pailpoe/MiniThread/documentation/Doc Utilisation_ MiniThread_r4.pdf

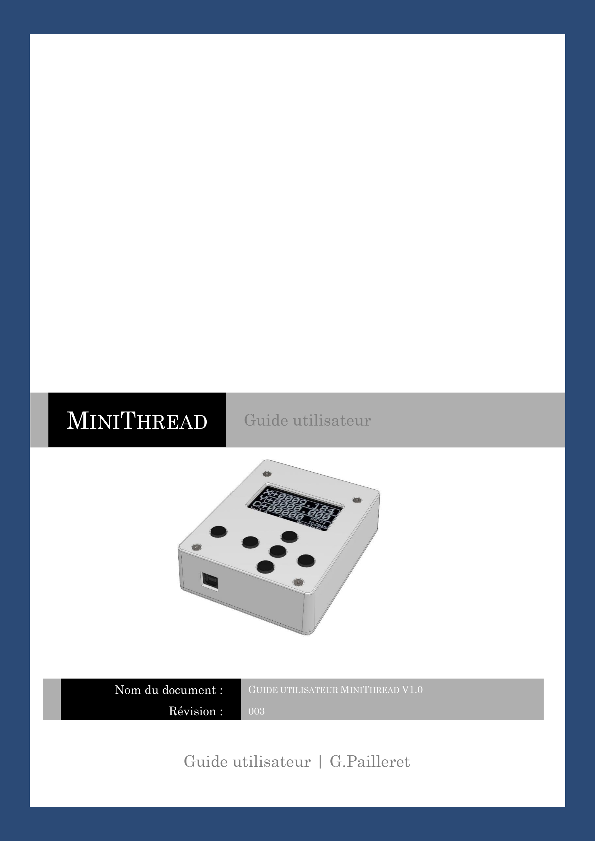
[picture p1: page 1]

## Guide utilisateur | G.Pailleret

MINITHREAD | Guide utilisateur
Nom du document : | GUIDE UTILISATEUR MINITHREAD V1.0
Révision : | 003

MiniThread | Guide utilisateur | 29 novembre

## Table des révisions

Révision | Détails | Auteur | Date
000 | Création du document | G.Pailleret | 21/11/2020
001 | Modification mineure Ajout calcul formule offset variable dans Annexe 3 | G.Pailleret | 21/11/2020
002 | Rajouts de détails dans différentes sections. Mise à
jour de la doc en fonction du logiciel 1.1.0.

Documentation écrite pour un choix de langue « FR »

G.Pailleret | 29/11/2020
003 | Ajout des profils Sphère et cône en intérieur /
extérieur et gauche /droite de la version logiciel 1.2.0.
G.Pailleret | 06/12/2020

## Table des matières

### 1. PRESENTATION

## 1.1 Avertissement

ATTENTION : Veuillez lire et comprendre l’intégralité du présent manuel avant de tenter d’installer ou de faire fonctionner le boitier MiniThread pour éviter tous risques d’accident grave.

ATTENTION : Le boitier MiniThread est un développement Open source (hardware, software, mécanique). Je ne suis pas responsable des dommages que sa mauvaise utilisation ou une défaillance du boitier pourraient occasionner. Soyez conscient des risques que vous prenez.

Toutes reproductions à des fins commerciales est interdites ! Me contacter si besoin.

## 1.2 Le projet

Le boitier MiniThread est un développement « DIY » open-source développé par Guillaume Pailleret (pseudo Pailpoe sur le forum français www.usinages.com »). Il représente des centaines d’heure de travail étalé sur 2 ans pour concevoir la carte, le logiciel, la mécanique et la documentation associée !

Le logiciel est disponible sur mon dépôt github : https ://github.com/pailpoe/MiniThread

Adresse email de contact : minithread@laposte.net

## 1.3 Remerciement

Je tiens à remercier les personnes sans qui ce projet n’aurait jamais vu le jour :

- Roger Clarke pour le Core Arduino pour STM32F103 qui m’a énormément simplifié le travail ( https ://github.com/rogerclarkmelbourne/Arduino_STM32 )
- Alexander ‘Spirik’ Spiridonov pour sa librairie de gestion de menus GEM qui est le cœur du système et qui m’a donné envie de relancer le projet en pause depuis 1 an
(https ://github.com/Spirik/GEM) .
- Mike McCauley pour sa librairie de gestion des moteurs pas à pas AccelStepper qui m’a servi pour la mise en place de l’accélération
(https ://www.airspayce.com/mikem/arduino/AccelStepper/).
- Les membres du forum Usinages.com qui m’ont motivé à avancer.

## 1.4 Document

Ce document à plusieurs objectifs :

- Expliquer comment utiliser le boitier MiniThread.
- Expliquer comment le régler.
- Expliquer comment choisir les composants externes comme les capteurs de position, les moteurs et les drivers.
- …

## 1.5 Le boitier MiniThread : les fonctionnalités

Le boitier MiniThread est destiné à offrir des fonctionnalités supplémentaires à un tour à métaux. Les fonctions dépendent de l’équipement du tour :

Fonctionnalités du boitier MiniThread en fonction de l’équipement

Axe longitudinal
Capteur sur le X

# Capteur sur le Y Axe transversal

Axe
Capteur sur le C

de broche

Axe longitudinal
Moteur sur le X

Axe
Moteur sur le Y

transversal

Général
Interface multi langue : Français et Anglais

Sauvegarde des réglages à la remise sous tension

DRO fonctions (affichage de position)

Affichage de la position de l’axe X au 1/1000 de mm | X
Remise à zéro de l’axe X | X
Affichage de la position de l’axe Y au 1/1000 de mm | | X
Remise à zéro de l’axe Y | | X
Mode diamètre pour l’axe Y | | X
Entrer d’une valeur pour un axe (ex : 12.5) | X | X
Correcteur d’outils (10 outils) sur X et Y | X | X
Mode Absolu / relatif pour les axes X et Y | X | X
Affichage de la vitesse de la broche en tour/min | | | X
Affichage de la position de la broche sur un tour en degré | | | X

Fonctions de chariotage sur longitudinal

Chariotage Automatique ou manuel sur butée électronique | X
Ajustement rapide des butées électronique en Manuel | X
Réglage des butées, déplacement des butées, … | X
Passage en mode rapide « bouton » | X

Fonctions de filetage

Filetage semi-automatique entre butées électronique ( int, ext, gauche et droite). | | X | X
Décalage dans le pas pour la reprise de filets endommagés | | X | X
Descente oblique avec choix de l’angle en degré | X | X | X

Fonctions de profil (sphère, cône)

Profil en mode semi-automatique (l’opérateur gère le transversal en manuel) | X | X
Profil à droite | X | X
Profil à gauche | X | X
Profil intérieur | X | X
Profil extérieur | X | X

Sphère (choix du rayon, de la position) | X | X
Congé (choix de l’angle, de la longueur) | X | X

Le boitier a été développé à la base pour être monté sur un tour d’outilleur type Schaublin 102 mais il peut être monté sur d’autres tours de plus ou moins grande taille en adaptant certains composants externes au boitier.

Exemple de réalisations possible avec le boitier :

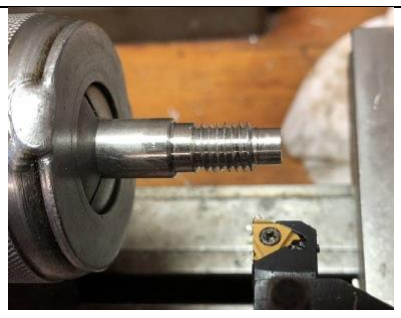
[picture p2: figure]

Filetage extérieur

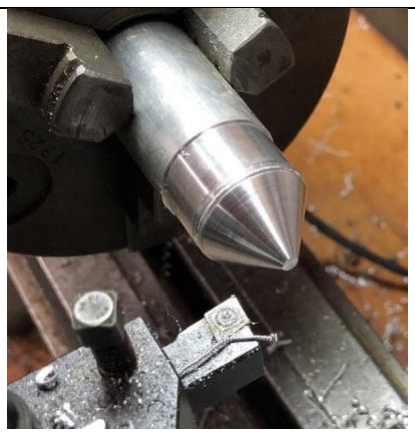
[picture p3: figure]

Cônes

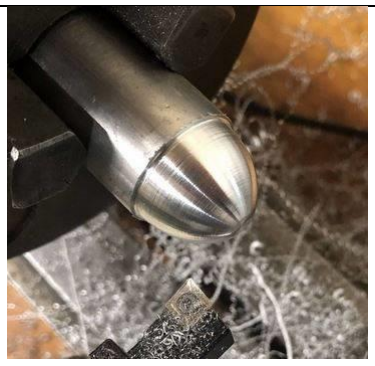
[picture p4: figure]

Sphères

## 1.6 Les axes du boitier

Les axes sont assignés de cette façon sur le boitier (qui diffère du standard !!). Cette notation est historique au projet et sera peut-être changé si j’ai le temps.

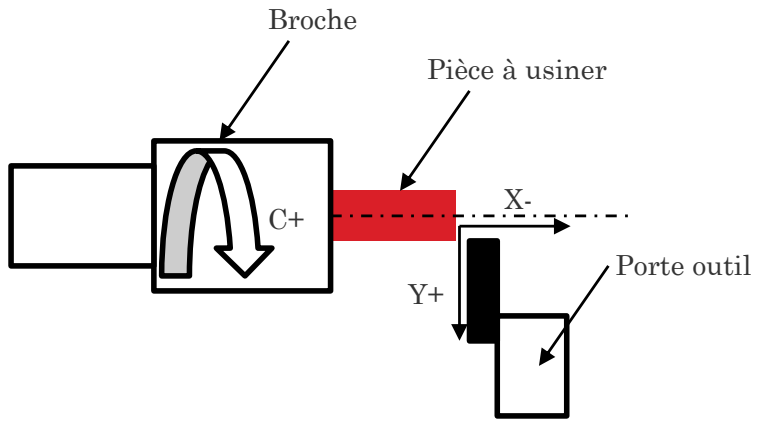
[picture p5: figure]
Broche; Pièce à usiner; Porte outil

- Le sens de rotation normal de la broche est donc en C+
- Le X est sur le longitudinal (X- on s’écarte de la pièce)
- Le Y est sur le transversal (Y+ on s’écarte de la pièce)

## 1.7 Evolution logiciel

1..0.0 : Première version

Fonctionnalités :

- Affichage en mm des axes X et Y (règles avec sortie en quadrature)
- Coord absolue / relatifs pour X et Y
- Configuration sens et résolution pour X et Y
- Entrée d’une valeur sur X et Y

- Mode diamètre sur Y
- Affichage axe C (broche) vitesse en tour/min et position en degré
- Configuration sens et résolution pour C
- Gestion d’un moteur sur l’axe X (longitudinal)
- Gestion de l’accélération / décélération
- Réglage Vitesse Max, Accélération, Pas vis, ….
- Butée électronique Min et Max
- Mode automatique et manuel avec vitesse rapide et changement de vitesse
- Modes filetage synchronisé
- Extérieur sens 1 (pas à droite)
- Extérieur sens 2 (pas à gauche)
- Intérieur sens 1 (pas à gauche)
- Intérieur sens 2 (pas à droite)
- Choix du pas par incrément de 1/100 de mm
- Du décalage dans le pas entre 0° et 360°
- Attaque droite ou oblique avec choix de l’angle sur tous les modes de filetage
- Bridage logiciel pour éviter les crashs de l’outil

Limitations :

- Le moteur 2 n’est pas encore commandé
- Correcteurs d’outils non fonctionnelles

Bugs :

- Pas de bugs connus

1.1.0

Fonctionnalités :

- 1.0.0 +
- Ajout de la gestion multi langue dans le menu settings (Anglais et Français). La langue par défaut est le français.
- Ajout du sous menu accès rapide pour gagner du temps.
- Touches en mode MANU pour ajustement des fins de course du moteur.
- Redesign des messages d’alerte qui sont maintenant aussi en français.
- Bridage en filetage oblique du décalage au demi pas en cas plongée trop profonde.
- Possibilité de se décaler dans le pas pendant le filetage plus facilement pour la reprise d’une vis endommagée. La broche doit être arrêtée pour faire cet ajustement pendant le cycle de filetage.
- Ajout communication limitée en USB (envoi des positions X, Y, C et M en continu).
- Ajout d’un petit jeu « Snake »

Limitations :

- Le moteur 2 n’est pas encore commandé
- Correcteurs d’outils non fonctionnelles

Bugs :

- Correction de bugs mineur

1.2.0

Fonctionnalités :

- 1.1.0 +
- Ajout des profils Sphère et cône

- INT / EXT
- LEFT / RIGHT
- Mise en place de gem 1.2.4
- Ajout du paramètre backlash pour le transversal.
- Modifications mineures.

Limitations :

- Le moteur 2 n’est pas encore commandé
- Correcteurs d’outils non fonctionnelles
- Profondeur de passe constante en mode PROFIL. L’angle du cône n’est pas prit en compte pour compenser la profondeur de passe.

Bugs :

- Correction de bugs mineur

### 2. LE BOITIER MINITHREAD

## 2.1 Les interfaces homme – machine

- Le boitier est muni d’un écran Oled de 128x64 pixels de 2,42 pouces
- 6 boutons servant pour la navigation
- Une prise USB type B servant à l’alimentation

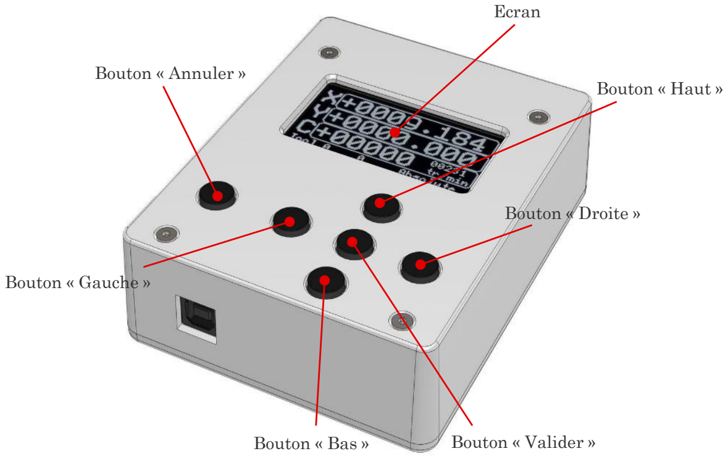
[picture p6: figure]
Ecran; Bouton « Haut »; Bouton « Bas »; Bouton « Annuler »; Bouton « Droite »; Bouton « Gauche »; Bouton « Valider »

## 2.2 Les connexions externes

Le boitier est muni de 4 prises Sub-D 9 broches pour le branchement des moteurs et des encodeurs

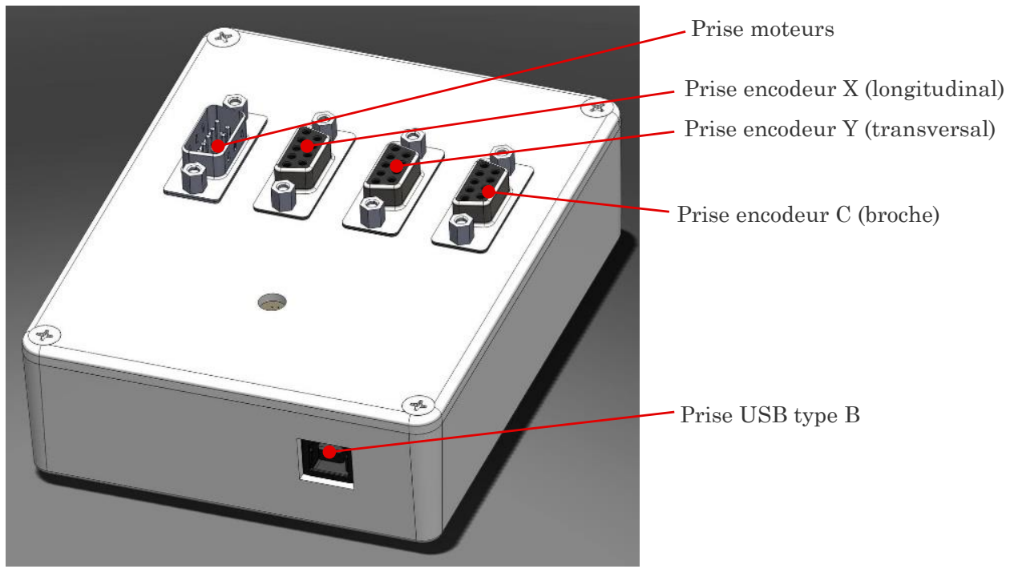
[picture p7: figure]
Prise moteurs; Prise encodeur X (longitudinal); Prise encodeur Y (transversal); Prise encodeur C (broche); Prise USB type B

Voir plus loin dans la documentation pour le choix des composants externe au système.

Prise moteur

Prise : Sub-D 9 mâle

Moteur 1 : X (longitudinal)

Moteur 2 : Y (transversal)

Mode : sortie en mode « Step, Dir, En ».

Le +5v présent sur la prise est
directement | repris | de
l’alimentation USB.
Broche | Assignation | Description | Type
1 | +5V MOT 1 | +5v moteur 1
2 | EN MOT 1 | Activation moteur 1 | Sortie collecteur ouvert

3 /

4 | EN MOT 2 | Activation moteur 2 | Sortie collecteur ouvert
5 | +5V MOT 2 | +5v moteur 2
6 | STEP MOT 1 | Step moteur 1 | Sortie collecteur ouvert
7 | DIR MOT 1 | Direction moteur 1 | Sortie collecteur ouvert
8 | DIR MOT 2 | Direction moteur 2 | Sortie collecteur ouvert
9 | STEP MOT 2 | Step moteur 2 | Sortie collecteur ouvert

Sortie du type collecteur ouvert avec un courant maximum de 140mA

Prises encodeur

Prise : Sub-D 9 femelle

Le boitier est muni de 3 prises pour des encodeurs en quadrature (A, B) alimentées en +5v. Il a été fait le choix de ne pas intégrer la gestion des complémentaires A/ et B/ dans le boitier (RS422) mais il est possible de connecter les signaux A et B sans les complémentaires en entrée de boitier (les

Broche | Assignation | Description | Type
1 /
2 | GND | Gnd de l’encodeur

3 /
4 /
5 /
6 | A | Signal A de l’encodeur | Voir en dessous
7 | +5V | +5v de l’encodeur
8 | B | Signal B de l’encodeur | Voir en dessous

9 /

niveaux sont acceptables pour que le boitier puisse les décoder).

Le +5v présent sur la prise est directement repris de l’alimentation USB.

Voir les spécifications du 74HC4050D pour plus de détails sur les niveaux acceptables. Le circuit d’entrée est alimenté en 3v3 en interne.

Niveau bas : Max 0,9v

Niveau haut : Min 2,32v, Typ = 1,85v

## 2.3 Dimensions

A compléter

## 2.4 Les spécifications techniques

Quelques spécifications techniques importantes.

Paramètre | Description | Unité | Min | Max
Vdd_USB | Tension d’alimentation du boitier (fournit par le port USB) | V | 4,5 | 5,5
I_USB | Courant consommé par le boitier sur le port USB sans capteurs branchés | mA | / | 250
MotorMaxFreq | Fréquence maximum des signaux Step sur les sorties moteur | Hz | / | 30K
EncoderMaxFreq | Fréquence maximum des encodeurs après décodage en quadrature | Hz | / | 1m

### 3. LES COMPOSANTS EXTERNE AU BOITIER

## 3.1 L’alimentation du boitier

Le boitier est muni d’une prise USB type B qui permet son alimentation par l’intermédiaire d’un bloc secteur type « téléphone ». La puissance minimum du boitier secteur doit être choisit pour permettre l’alimentation du boitier MiniThread ainsi que les différents capteurs (règle linéaire et encodeur de rotation).

Un courant de sortie de 1A (5w) semble être un bon choix pour le bloc secteur servant à alimenter le boitier.

## 3.2 Les capteurs de position pour les axes X et Y

Fonction

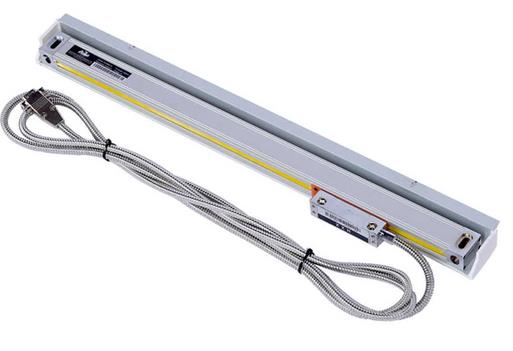
[picture p8: figure]

Deux capteurs peuvent être installer sur les axes X et Y.

Ces 2 capteurs ne sont pas obligatoires pour le fonctionnement du système mais il est fortement recommandé de les installer pour profiter de certaines fonctionnalités.

Mon chariot est équipé de capteurs de déplacement magnétique qui sortent des signaux en quadrature (développé sur un autre projet). Il est possible d’utiliser des capteurs plus standard en verre ou des capteurs magnétiques.

Câblage des capteurs

(RAPPEL)

Les capteurs en quadrature de type règle en verre ou magnétique sont souvent munis d’une prise Sub D 9 points mâle. Ce câblage a donc été appliqué sur l’ensemble des capteurs du système. Il est bien sur possible de changer ce câblage si on utilise une autre assignation sur ses capteurs.

Broche | Assignation
1 /
2 GND
3 /
4 /
5 /
6 A
7 +5V
8 B
9 /

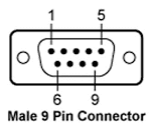
[picture p9: figure]

Sur mon chariot Schaublin 102 (longitudinal et transversal)

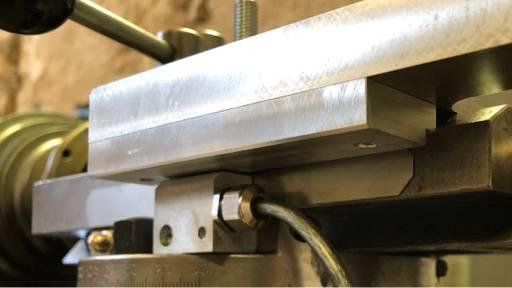
[picture p10: figure]

Des capteurs magnétiques de fabrication personnelle sont
installés. Ils utilisent des capteurs magnétiques de chez
AMS, des AS5311. Ces capteurs sortent directement les
signaux en quadrature A et B.

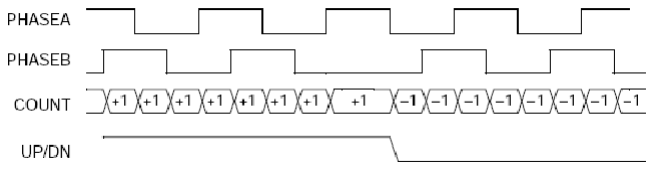
[picture p11: figure]
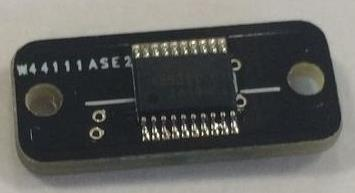
[picture p12: figure]

Les circuits ont été intégrés dans un bottier usiné en aluminium et de la résine a été coulé.

La bande magnétique a été intégré directement dans les chariots (fraisage) puis une protection inox a été posé devant ( bande inox de 0,1mm d’épaisseur sur 12mm de large).

Voir mon projet dédié à ces capteurs.

Voir le site d’AMS pour plus de détails.

https://ams.com/as5311
Réglage

Le réglage des paramètres des règles se fait dans le menu settings (X et Y). Il est possible de régler pour chaque capteur sa résolution en step/mm ainsi que le sens de lecture.

Les réglages sont sauvegardés dans la mémoire non volatile et seront rétablis à la remise sous tension du boitier.

Exemple :

Pour une règle en verre ayant une résolution de 5µm, la résolution sera réglée à 200 step/mm

Le capteur AMS / AS5311 que j’utilise sur mes règles à une résolution de 512 step/mm

## 3.3 Le capteur de rotation de broche (Axe C)

Fonction

Cette fonction a pour objectif de mesurer la position de la broche du tour pendant le fonctionnement du système.

Elle est réalisée par un capteur rotatif en quadrature sortant 2 signaux A et B en quadrature.

Le boitier MiniThread ne gère pas les signaux complémentaires A/ et B/. Il n’est donc pas nécessaire de les câbler sur le boitier.

Choix du capteur

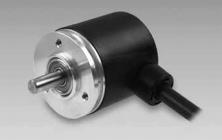
[picture p13: figure]

Il faut choisir un capteur ayant une résolution suffisante. Le système a été mis au point avec une résolution de 1200 point par tour d’axe de broche après le décodage en quadrature et la réduction mécanique de 3.

Il faudra veiller à la vitesse maximum acceptable par le capteur pour ne pas dépasser ses capacités en fonctions de la vitesse maximum de la broche.

Un capteur de 100 PPR (Pulses Per Revolution) aura une résolution de 400 pas/tour avec décodage des signaux A et B en quadrature (prise en compte des fonts montants et descendants sur les voies A et B).

Choix du capteur dans mon système

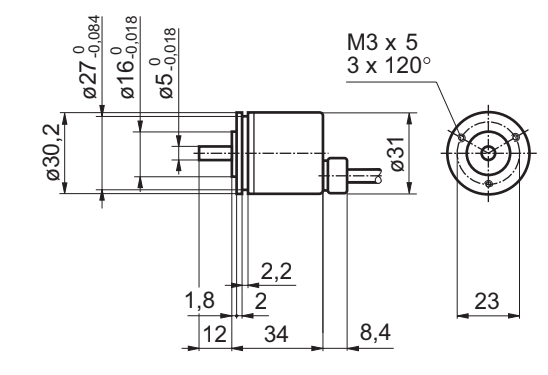
[picture p14: figure]

Le capteur utilisé vient de chez Baumer Ref : BDK
16.05A100-5-4

Ce choix a été fait pour sa disponibilité pendant la conception !

C’est un capteur PPR=100 pas/tour qui avec un décodage X4 (fronts montants et descendants sur les canaux A et B) donne une résolution de 400 pas/tour d’axe. Il est muni d’un axe de 5mm.

La liaison entre le codeur et la broche s’effectue par 2 poulies avec un pas T2.5 (2.5mm de pas). Une poulie de 20 dents (alésée à 5 mm) qui est montée sur le codeur et une poulie de 60 dents qui est montée sur la broche (alésée à 29mm). Une courroie de 6mm de large (T2.5) de 168 dents a été choisie.

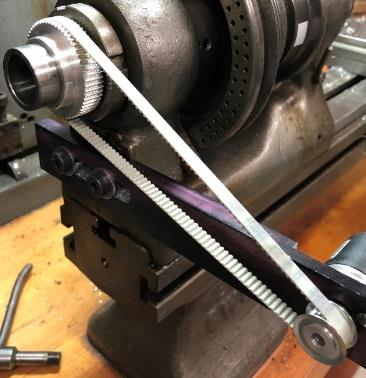
[picture p15: figure]

Le codeur donnant une résolution de 400 pas/tour associé à une réduction de 3 par le système poulie / courroie nous donne une résolution de 1200 pas/tour pour la position broche.

Câblage du capteur de rotation

(RAPPEL)

Les capteurs en quadrature de type règle en verre ou magnétique sont souvent munis d’une prise Sub D 9 points mâle. Ce câblage a donc été appliqué sur l’ensemble des capteurs du système. Il est bien sur possible de changer ce câblage si on utilise une autre assignation sur ses capteurs.

Broche | Assignation
1 /
2 GND
3 /
4 /

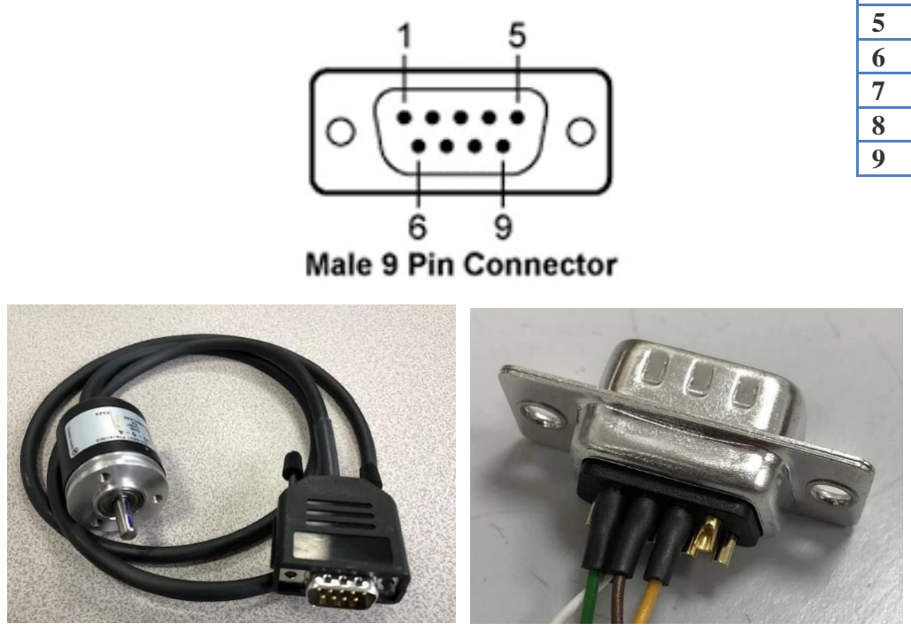
[picture p16: figure]

5 /
6 A
7 +5V
8 B
9 /

Réglage

Le réglage des paramètres du capteur de rotation se fait dans le menu settings (C). Il est possible de régler sa résolution en step/tr ainsi que le sens de lecture. La résolution rentrée doit prendre en compte le décodage de la quadrature ainsi que la réduction mécanique si elle est présente.

Les réglages sont sauvegardés dans la mémoire non volatile et seront rétablis à la remise sous tension du boitier.

Exemple :

Capteur de 100 PPR avec une réduction mécanique de 3 : 100 x 4 x 3 = 1200, la résolution sera de 1200 step/tr.

## 3.4 La motorisation du longitudinal (Axe X)

Fonction

Cette fonction a pour objectif de faire l’interface entre la sortie moteur du boitier et la mise en rotation de la vis de déplacement. Elle utilise pour cela plusieurs composants :

- Un moteur pas à pas
- Un driver pour moteur pas à pas
- Une alimentation de puissance pour l’alimentation du driver

Choix du moteur / Tension d’alimentation / Driver

A compléter

Câblage

(RAPPEL)

Le boitier MiniThread est munit de 2 sorties moteurs qui sont disponibles sur une prise

Broche | Assignation | Type

SubD 9 broches male. Le moteur 1 est assigné au moteur du longitudinal (X) et le moteur 2 au transversal (Y).

Les sorties sont du type collecteur ouvert.

1 +5V MOT 1

2 | EN MOT 1 | Sortie collecteur ouvert

3

4 | EN MOT 2 | Sortie collecteur ouvert

5 +5V MOT 2

6 | STEP MOT 1 | Sortie collecteur ouvert
7 | DIR MOT 1 | Sortie collecteur ouvert
8 | DIR MOT 2 | Sortie collecteur ouvert
9 | STEP MOT 2 | Sortie collecteur ouvert

Exemple de câblage (documentation d’un driver moteur type DM542). Pour un fonctionnement sous 5v, il n’y a normalement pas besoin de rajouter des résistances de limitation du courant sur les sorties (R sur le schéma).

Vcc = +5v

Réglage

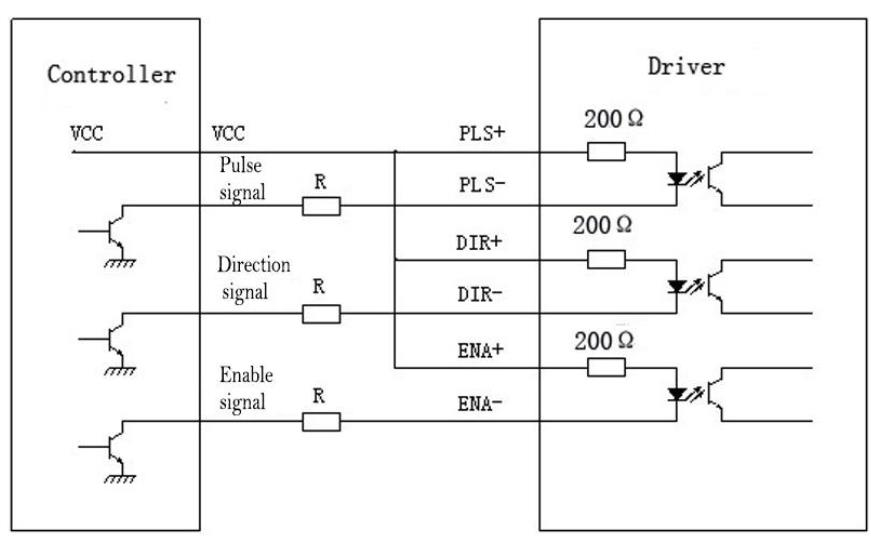
[picture p17: figure]

Les réglages du moteur1 se trouve dans le menu settings.

- M1 dir : Direction du moteur 1 (coché pour inverser le sens de rotation)
- M1 step/tr : Suivant le réglage fait sur le driver, rentrer le nombre de pas par tour (exemple : 1600)
- M1 thread : Pas de la vis entrainée par le moteur (exemple : 200 pour 2mm)
- M1 accel : Accélération du moteur en step/s² (voir l’Annexe 2 pour plus de détails sur le choix de l’accélération).
- M1 speed : Vitesse maximum du moteur step/s, cette vitesse sera la vitesse maximum pendant les phases automatique comme le filetage ainsi que pour les retours rapides (voir l’Annexe 2 pour plus de détails sur le choix de la vitesse maximum).

Le choix fait

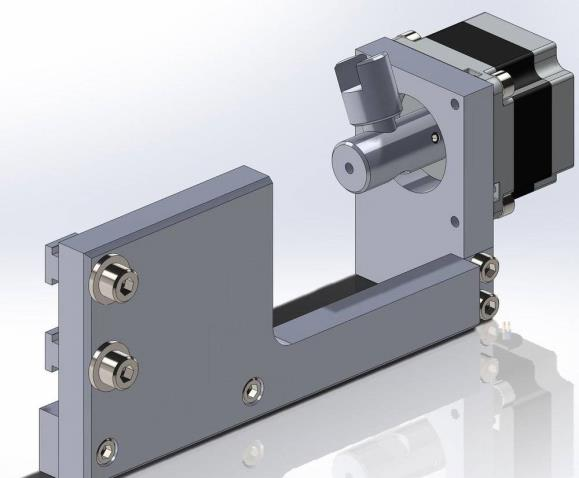
[picture p18: figure]

Pour l’entrainement longitudinal du chariot Schaublin 102, il a été choisi de ne pas modifier le
chariot | d’origine | donc | le | moteur | entraine
directement la manivelle. L’ensemble est fixé sur la table par l’intermédiaire des 2 rainures déjà présentes. Les plans mécaniques de cet accessoire sont disponibles si besoin.
- Moteur pas à pas Nema 23
- Driver DM542
- Alimentation 24v/4A
- Le driver est configuré à 1600 pas/tour,
| 2,3A

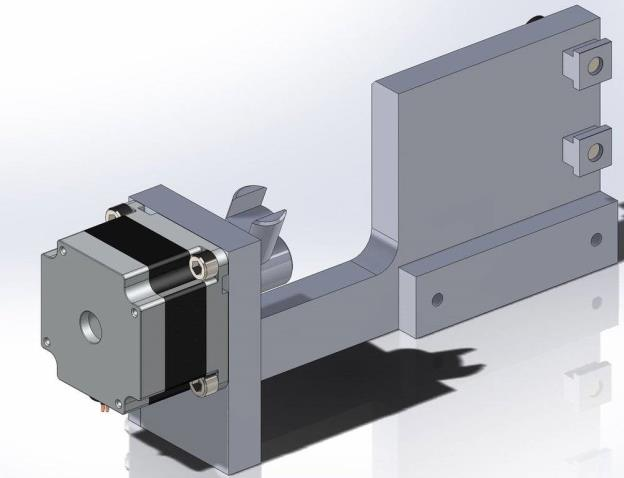
[picture p19: figure]

- Le pas de la vis du chariot est de
2mm/tour

Les performances sont conformes aux attentes avec un montage très rapide sur le chariot en vissant les 2vis. On peut donc rapidement repasser en manuel sur les 2 axes.

Même si maintenant, l’entrainement reste à demeure sur le chariot et je ne manipule plus les X manuellement.

### 4. UTILISATION DU BOITIER

Les captures d’écran ont été réalisés en langue française.

## 4.1 Rappel

Le boitier est muni de 6 touches pour la navigation dans les menus et d’autres fonctions et d’un écran

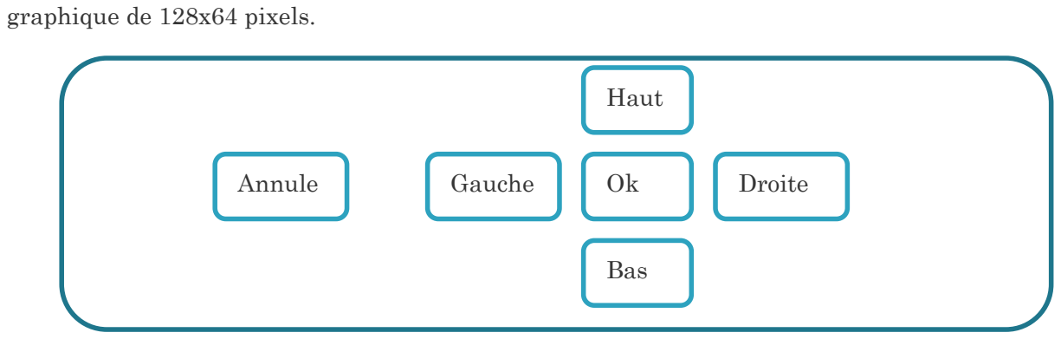
[picture p20: figure]
graphique de 128x64 pixels.; Haut; Bas; Annule; Gauche; Droite

## 4.2 La navigation

Le système est composé d’un menu avec des sous menus permettant d’ajuster les différents paramètres du système ainsi que d’un écran de « travail ».

Ecran de travail principal

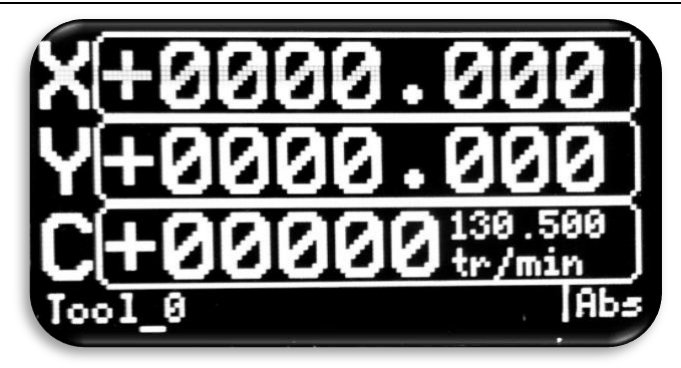
[picture p21: figure]

On rentre dans le menu depuis l’écran de travail en appuyant sur la touche « Annuler »

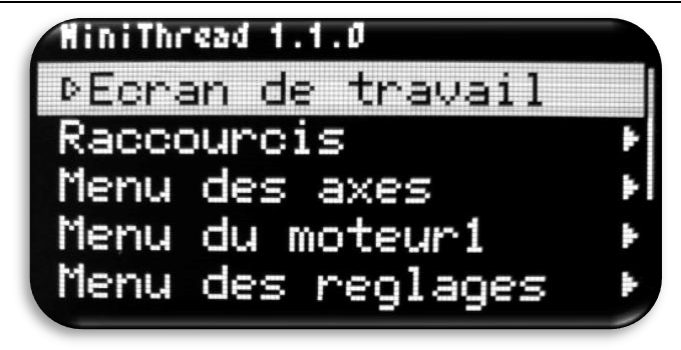
[picture p22: figure]

Ecran des menus

Ecran des menus ( Anglais)

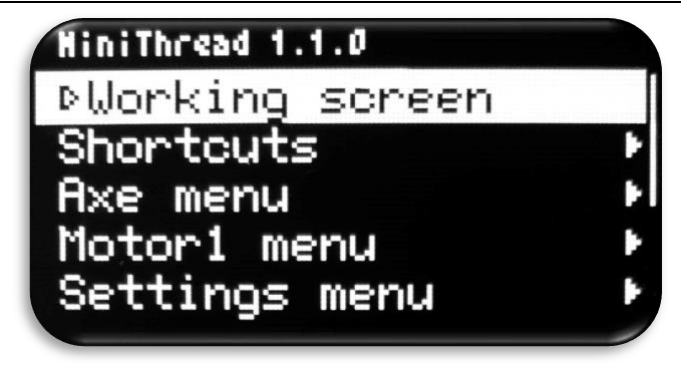
[picture p23: figure]

Le retour depuis le menu à l’écran de travail se fait en positionnant le curseur sur « Return to screen » et en validant avec la touche « OK ».

Dans le menu et les sous menus, la navigation s’effectue avec les touches « Haut » et « Bas », on peut éditer une valeur ou rentrer dans un sous-menu avec la touche « OK », la touche « Cancel » permet d’annuler l’édition en cours ou de retourner dans le menu supérieur.

L’ergonomie est assez intuitive.

L’interface est traduite en 2 langues(français et anglais) (voir le menu réglage pour le changement de la langue de l’interface).

## 4.3 Ecran de travail

L’écran de travail peut être modifié en appuyant sur la touche « OK » comme par exemple afficher l’état de la broche ou les informations moteur. Pendant la rotation du moteur, cette touche est attribuée à la vitesse rapide (il est alors impossible de voir les informations de la broche).

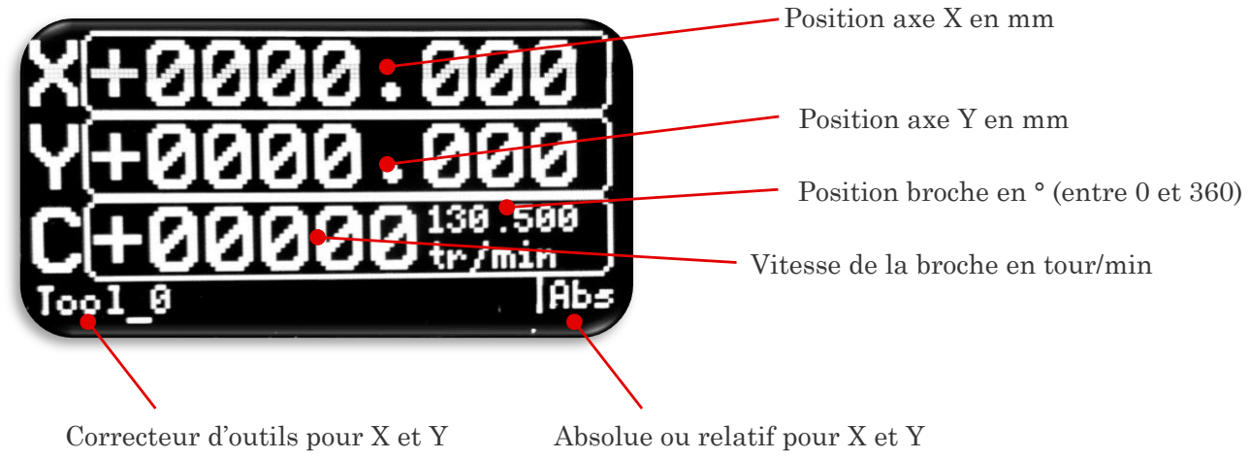
[picture p24: figure]
Position axe X en mm; Position axe Y en mm; Vitesse de la broche en tour/min; Position broche en ° (entre 0 et 360)

Correcteur d’outils pour X et Y | Absolue ou relatif pour X et Y

Et donc en appuyant sur « Ok », on arrive à cet affichage (les informations de l’axe C sont remplacées par les informations du moteur pas à pas 1 sur le X) :

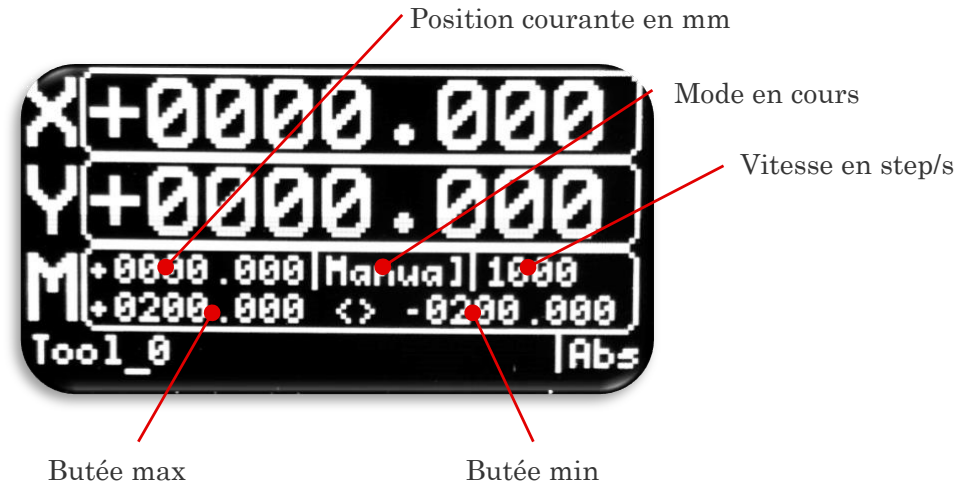
[picture p25: figure]
Position courante en mm; Mode en cours; Vitesse en step/s; Butée max; Butée min

Certaines touches de la navigation sont réattribuées pendant certaines actions avec le moteur.

## 4.4 Réglage du boitier

Avant tout opération, le boitier a besoin d’être réglé, il faut se rendre dans le sous menu réglage depuis le menu principal :

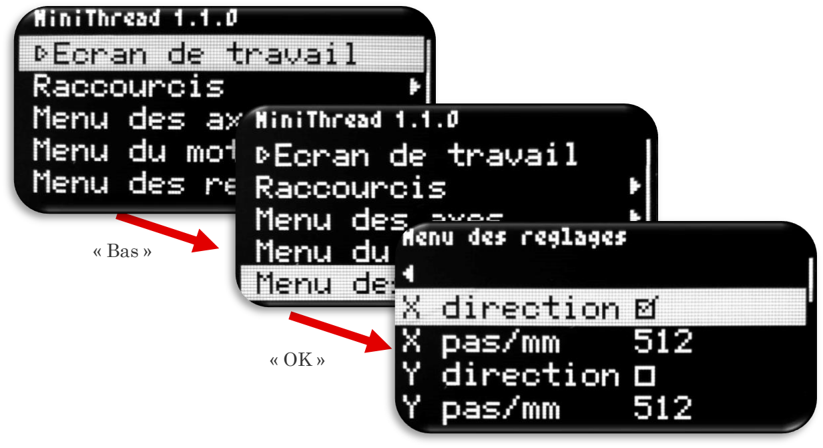
[picture p26: figure]
« Bas »

L’ensemble des paramètres de réglage se trouvent dans ce menu. Ils seront sauvegardés et restaurés par la suite à la remise sous tension du boitier.

Elément Fr | Elément En | Type | Description
X direction | X dir | A cocher | Sens de lecture du capteur de l’axe X. En cochant cette case, le sens change. La valeur de X doit augmenter quand l’outil revient vers la broche.
X pas/mm | X step/mm | Nombre entier | Nombre de Pas/mm du capteur de l’axe X (entre 1 et 10000).
Y direction | Y dir | A cocher | Sens de lecture du capteur de l’axe Y. En cochant cette case, le sens change. La valeur de Y doit augmenter quand l’outil s’écarte de la pièce.
Y pas/mm | Y step/mm | Nombre entier | Nombre de Pas/mm du capteur de l’axe Y (entre 1 et 10000).
C direction | C dir | A cocher | Sens de lecture du capteur de l’axe C (broche). En cochant cette case, le sens change. L’axe C doit être positif en sens normal de la broche
C pas/tr | C step/tr | Nombre entier | Nombre de Pas/mm du capteur de l’axe C (entre 1 et 10000).
Y diamètre | Y diameter | A cocher | Utilisation ou nom de l’affichage au diamètre sur l’axe Y. Si cette case est cochée, un déplacement de 1mm sur l’axe Y sera affiché à 2mm.
M1 dir | M1 dir | A cocher | Sens de rotation du moteur 1 (axe X longitudinal). La valeur de la position moteur doit augmenter quand l’outil revient vers la broche.
M1 pas/tr | M1 step/tr | Nombre entier | Nombre de pas par tour du moteur 1 (entre 1 et 10000). Ce réglage dépend du réglage du driver. Voir l’Annexe 2 pour plus de détails.
M1 pas | M1 thread | Nombre entier | Pas en 1/100 de la vis entrainant l’axe X (entre 1 et 10000). Exemple « 200 » pour 2mm
M1 accel. | M1 accel | Nombre à virgule | Accélération du moteur en step/s² (entre 1 et 500000). Dépend de l’inertie du système. A ajuster au mieux. Réglé à 60000 sur mon système. Voir l’Annexe 2 pour plus de détails.
M1 vitesse | M1 speed | Nombre entier | Vitesse maximum du moteur 1 en step/s (entre 1 et 30000). Cette vitesse est utilisée pendant les passages en vitesse rapide et pendant les phases automatiques comme le filetage. Sur mon système avec un driver réglé à 1600 pas/tour, j’ai mis 12000. Voir l’Annexe 2 pour plus de détails.
M1 jeu | M1 back | Nombre à virgule | Jeu au changement de sens de la vis du X en mm. Pour une vis à bille, cette valeur peut être nul. Cette valeur est utilisé par exemple pour la compensation du jeu dans les profils.
Langue | Language | Liste de choix | Choix de la langue de l’interface et des messages. Français (Fr) ou Anglais (En).
USB com. | USB com. | A cocher | Activation de la communication USB du boitier s’il est connecté à un ordinateur.
Restaurer | Restore | Bouton | Restaurer les paramètres par défaut
Sauvegarder | Save | Bouton | Enregistrement des réglages dans la mémoire

Après avoir rentré les paramètres, il faut absolument les validés en descendant jusqu’à « Save settings » et en appuyant sur la touche « Ok ». Un message d’information vous avertira de la bonne sauvegarde.

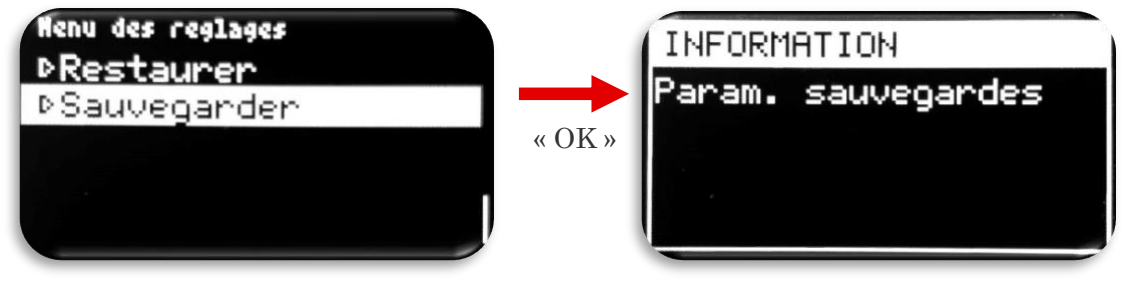
[picture p27: figure]

On peut alors revenir à l’écran principal en appuyant sur la touche « Annuler » puis sur l’écran de travail pour vérifier que tout fonctionne correctement.

Il est possible de restaurer les paramètres par défaut en cliquant sur « Restore settings ».

Exemple de réglage

A compléter

## 4.5 Menu des axes X et Y

Le sous menu « Menu des axes » permet de modifier les paramètres des axes X et Y (remise à zéro, entrer une valeur,…)

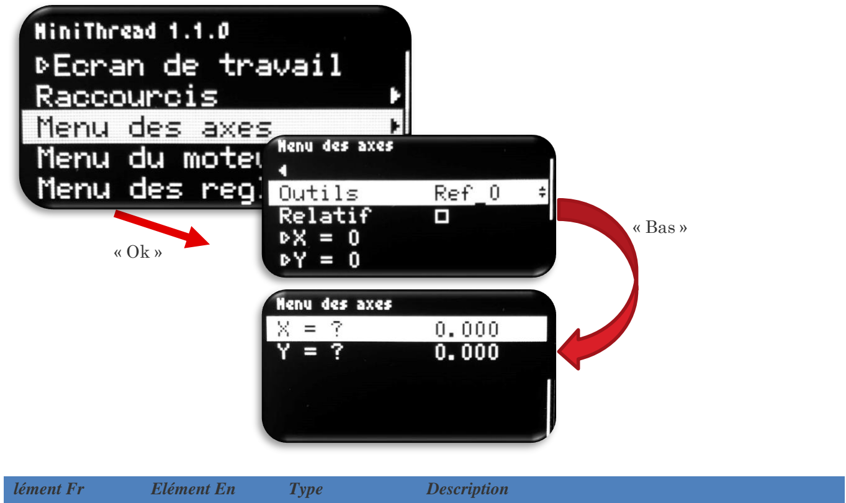
[picture p28: figure]
lément Fr; Elément En; Type; Description; « Bas »

Outils | Tool | Liste de choix | Choix de l’outil pour les correcteurs d’outils
Relatif | Relative | A cocher | Choix entre les coordonnés relatifs ou absolues pour les axes X et Y
X = 0 | X= 0 | Bouton | Remet à zéro X (pour les coordonnés en cours relatif ou absolu)

Y = 0 | Y = 0 | Bouton | Remet à zéro Y (pour les coordonnés en cours relatif ou absolu)
X = ? | X = ? | Nombre à virgule | Position de l’axe X en mm (pour les coordonnés en cours relatif ou absolu), il est possible d’éditer cette variable
Y = ? | Y = ? | Nombre à virgule | Position de l’axe Y en mm (pour les coordonnés en cours relatif ou absolu), il est possible d’éditer cette variable

Pour éditer une variable, rentrer en Edition de la variable en appuyant sur « Ok ». Utiliser les touches « Gauche » / « Droite » pour changer de caractères en édition et « Haut » / « Bas » pour changer la valeur. Finir en validant avec « Ok » ou annuler l’édition en appuyant sur « Annuler ».

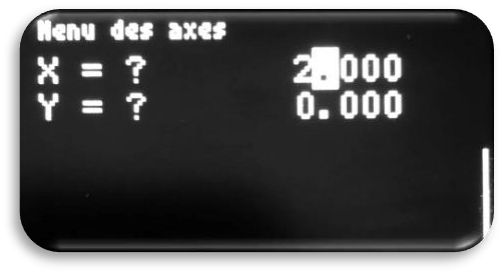
[picture p29: figure]

Pour les nombres à virgule, il est possible de choisir les caractères 0123456789.-

## 4.6 Menu des raccourcis

Le sous menu des raccourcis permet de lancer rapidement des actions que l’on utilise souvent. La différence avec les autres menus est que l’on revient au menu de travail quand l’action est lancée.

L’appui sur la touche « Ok » depuis l’écran de travail fait revenir directement dans ce menu pour gagner

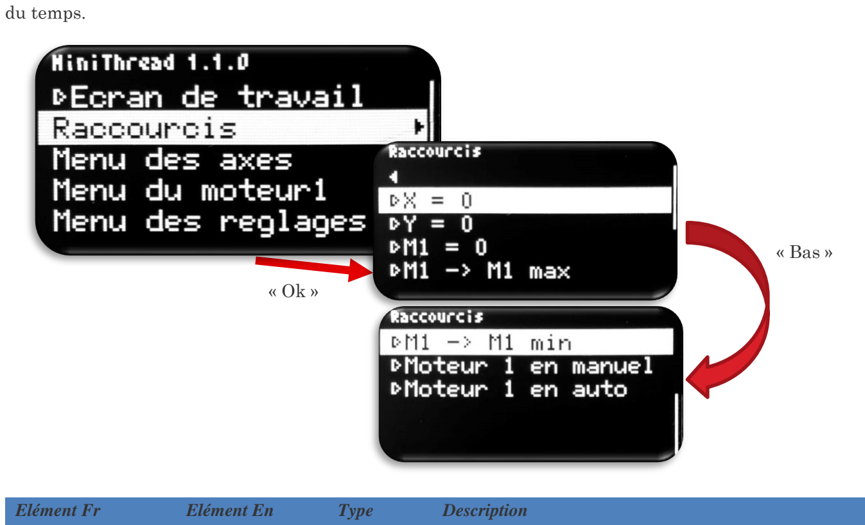
[picture p30: figure]
du temps.; Elément Fr; Elément En; Type; Description; « Bas »

X = 0 | X= 0 | Bouton | Remet à zéro X (pour les coordonnés en cours relatif ou absolu)
Y = 0 | Y = 0 | Bouton | Remet à zéro Y (pour les coordonnés en cours relatif ou absolu)
M = 0 | M = 0 | Bouton | Remet à zéro la position du moteur 1
M1 = M1 max | M1 = M1 max | Bouton | La butée max du moteur1 prend la valeur de la position du moteur 1
M1 = M1 min | M1 = M1 min | Bouton | La butée min du moteur1 prend la valeur de la position du moteur 1
Moteur 1 en manuel | Motor 1 manual | Bouton | Le moteur 1 fonctionne en mode MANU
Moteur 1 en auto | Motor 1 auto | Bouton | Le moteur 1 fonctionne en mode AUTO

## 4.7 Menu du moteur 1 (longitudinal)

Le sous menu « Menu du moteur 1 » permet de modifier les paramètres du moteur 1 installé sur le longitudinal et de choisir les fonctions que l’on souhaite utiliser.

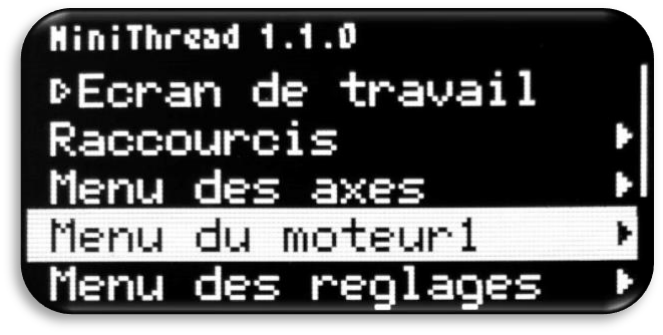
[picture p31: figure]

Par défaut, le paramètre « Active » n’est pas coché donc le moteur n’est pas piloté par le driver. L’axe peut alors être tourné librement.

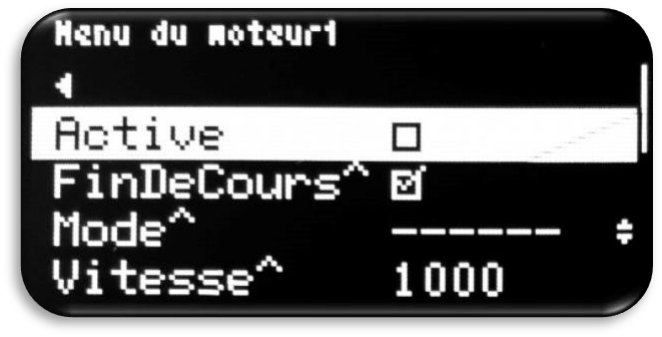
[picture p32: figure]

Le menu moteur possède 2 sous menus pour les paramètres du mode filetage et du mode profil.

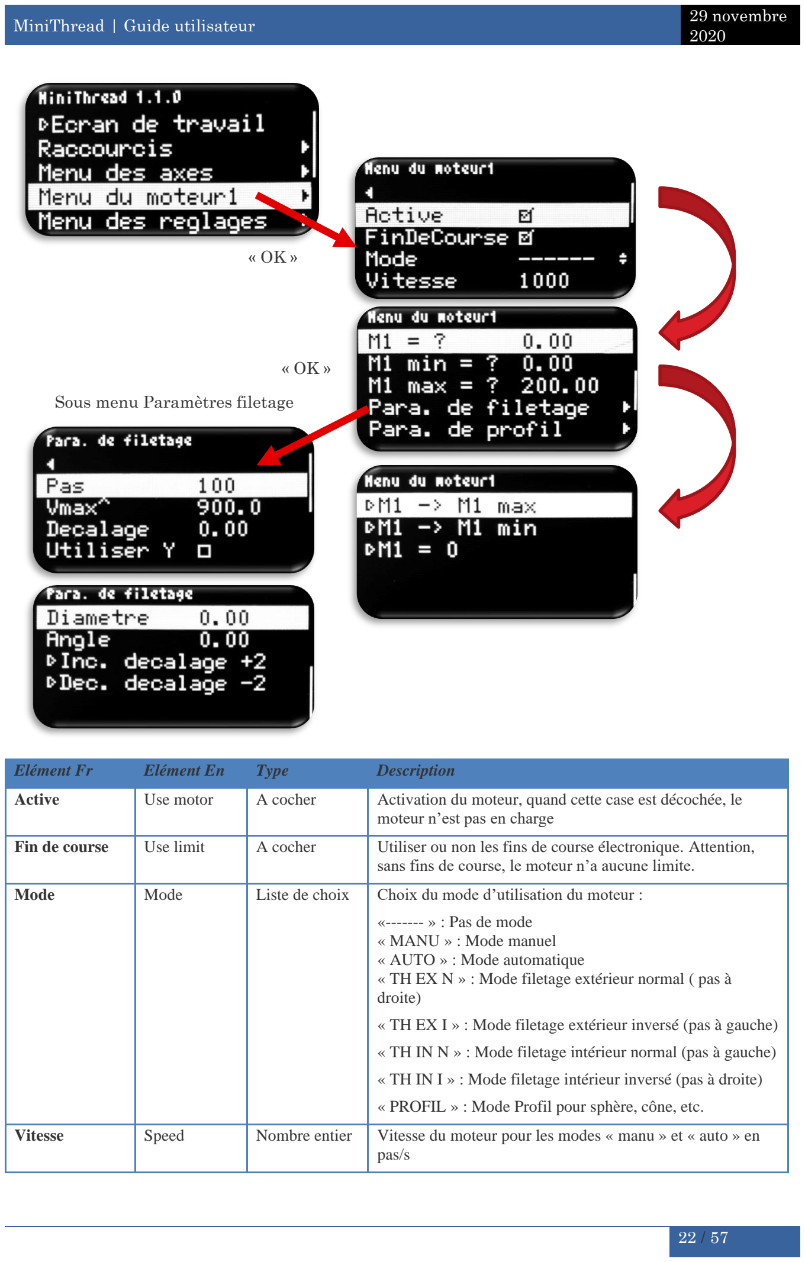
[picture p33: page 23]

Elément Fr | Elément En | Type | Description
Active | Use motor | A cocher | Activation du moteur, quand cette case est décochée, le moteur n’est pas en charge
Fin de course | Use limit | A cocher | Utiliser ou non les fins de course électronique. Attention, sans fins de course, le moteur n’a aucune limite.
Mode | Mode | Liste de choix | Choix du mode d’utilisation du moteur : «------- » : Pas de mode « MANU » : Mode manuel « AUTO » : Mode automatique « TH EX N » : Mode filetage extérieur normal ( pas à droite) « TH EX I » : Mode filetage extérieur inversé (pas à gauche) « TH IN N » : Mode filetage intérieur normal (pas à gauche) « TH IN I » : Mode filetage intérieur inversé (pas à droite) « PROFIL » : Mode Profil pour sphère, cône, etc.
Vitesse | Speed | Nombre entier | Vitesse du moteur pour les modes « manu » et « auto » en pas/s

« OK »

« OK »

Sous menu Paramètres filetage

M1 = ? | M1 = ? | Nombre à virgule | Position courante du moteur en mm. Cette valeur est éditable.
M1 min = ? | M1 min = ? | Nombre à virgule | Butée électronique minimum du moteur en mm. Cette valeur est éditable. Sa valeur est inférieure à la butée maximum.
M1 max = ? | M1 max = ? | Nombre à virgule | Butée électronique maximum du moteur en mm. Cette valeur est éditable. Sa valeur doit être supérieure à la butée minimum.
Para. de filetage | Thread parameters | Bouton | Accès au sous menu des paramètres du filetage
Para. de profil | Profil param. | Bouton | Accès au sous menu des paramètres de profil.
M1 -> M1 max | M1 -> M1 max | Bouton | Assigner la position courant du moteur à la butée électronique Max
M1 -> M1 min | M1 -> M1 min | Bouton | Assigner la position courant du moteur à la butée électronique Min
M1 = 0 | M1 = 0 | Bouton | Mettre à zéro la position courante du moteur

Sous menu pour les paramètres de filetage « para. de filetage » :

Elément Fr | Elément En | Type | Description
Pas | Thread | Nombre entier | Pas du filetage souhaité en 1/100 de mm pour le mode filetage. Exemple « 125 »
Vmax | Speed max | Nombre à virgule | Valeur non modifiable de la vitesse maximum de la broche en fonction des paramètres système et du pas sélectionné. Si la vitesse de broche est supérieure à cette valeur, le système ne pourra pas suivre.
Décalage | Offset | Nombre à virgule | Offset fixe du filetage en ° entre 0° et 360°. Ce paramètre permet de se décaler dans le pas en plus. A zéro degré, il n’y a pas de décalage, avec 360°, on se décale du pas complet.
Utiliser Y | Use Y | A cocher | Active les fonctions avancées du filetage en utilisant les informations de la règle Y sur le transversal. Quand cette case est cochée : - Le retour en mode rapide est impossible si l’affichage Y est inférieur à « Diamètre » (évite la casse de l’outil). - Attaque oblique en prenant en compte l’axe Y, le diamètre et l’angle -Engagement du filetage impossible si l’axe Y est supérieur à « Diamètre »
Diamètre | Diameter | Nombre à virgule | Diamètre extérieur du filetage en mm, cette valeur est utilisée pour les sécurités logiciels et le calcul du décalage variable en fonction de l’angle et du diamètre (attaque oblique de l’outil).
Angle | Angle | Nombre à virgule | Angle de la plongée oblique en ° entre 0 et 45°. Pour un pas métrique, l’angle est de 30°.
Inc. Decalage +2 | Inc Offset +2 | Bouton | Ajoute 2° au paramètre Décalage. Ce bouton permet de régler plus rapidement le décalage
Dec. Decalage -2 | Dec Offset -2 | Bouton | Enlève 2° au paramètre Décalage. Ce bouton permet de régler plus rapidement le décalage

Sous menu pour les paramètres de profils « para. de profil » :

Elément Fr | Elément En | Type | Description
Profil | Profil | Liste de choix | Choix du profil : « CONE » : Cône « SPHERE » : Sphère
Direction | Direction | Liste de choix | Choix de la direction : « LEFT » : Profil de droite à gauche « RIGHT » : Profil de gauche à droite
Position | Position | Liste de choix | Choix de la position : « EXT » : Profil en extérieur « INT » : Profil en intérieur
Passe | Deep | Nombre à virgule | Profondeur de passe en mm sur le rayon
Diamètre | Diameter | Nombre à virgule | Diamètre extérieur du profil en mm
Dia. ret | Dia. Ret | Nombre à virgule | Diamètre de retour utilisé si le profil est dans la matière. La matière entre le diamètre de retour et le diamètre sera enlevée. Exemple : Barre de 20mm Profil à 18mm de diamètre Mettre 20mm pour le diamètre de retour.
Angle | Angle | Nombre à virgule | Angle en degré du cône. Mettre 45° pour un chanfrein, mettre 0° pour une gorge.
Longueur | Lenght | Nombre à virgule | Longueur du cône en mm sur l’axe X
Rayon | Radius | Nombre à virgule | Rayon de la sphère en mm

Mode Manuel du moteur : « MANU »

Motor Mode | Manual
Pour faire quoi ? | Le mode manuel permet de déplacer l’outil de gauche à droite en maintenant le bouton « Gauche » ou « Droite » appuyé. Le déplacement est borné par les butées « M1 min » et « M1 max » si « FinDeCourse » est coché. Il est possible de se déplacer en vitesse normal ou en vitesse rapide (pour revenir rapidement à son point de départ par exemple).
Comment j’active ce mode ? | Dans le menu « Menu du moteur 1 » → « Mode » = « MANU » Ou dans le menu de raccourcis pour plus de rapidité.
Je règle quoi avant de démarrer ? | • Je renseigne les fins de course Min et Max et je choisi la bonne vitesse. Je peux changer les fins de course à tout moment dans le menu.
Comment j’utilise cette fonction ? | Avec les boutons « Gauche » ou « Droite » appuyés en permanence, l’outil se déplace. Il est possible d’ajuster les butées en appuyant sur « Haut » ou « bas » pendant que le les touches « Gauche » ou « droite » sont appuyés. Appui sur « Haut » et « Bas » pour changer la vitesse quand le moteur ne se déplace pas. Appui sur « OK » pour passer en vitesse rapide et tant que le bouton est appuyé (vitesse définie dans « Réglage » : « M1 vitesse »), la vitesse revient à sa valeur normale quand le bouton est relâché.
Max | Min

Ecran de travail

X+ | X-
Y+

Y-

Déplacement
De l’outil

Mode Automatique du moteur : « AUTO »

Motor Mode | Auto
Pour faire quoi ? | Le mode Automatique permet de déplacer l’outil de gauche à droite par un appui sur bouton « Gauche » ou « Droite ». Le déplacement est borné par les butées « Min » et « Max » si « FinDeCourse » est coché. Il est possible de se déplacer en vitesse normal ou en vitesse rapide (pour revenir rapidement à son point de départ par exemple).
Comment j’active ce mode ? | Dans le menu « Menu du moteur 1 » : « Mode » = « Auto » Ou dans le menu de raccourcis pour plus de rapidité.
Je règle quoi avant de démarrer ? | • Je renseigne les fins de course Min et Max et je choisi la bonne vitesse. Je peux changer les fins de course à tout moment.
Comment j’utilise cette fonction ? | Avec les boutons « Gauche » ou « Droite » je lance un déplacement, l’outil se déplace. Un appui de nouveau sur « Gauche » ou « Droite » arrête le déplacement. Appui sur « Haut » et « Bas » pour changer la vitesse quand le moteur ne se déplace pas. Appui sur « OK » pour passer en vitesse rapide et tant que le bouton est appuyé (vitesse définie dans « Réglage » : « M1 vitesse »), la vitesse revient à sa valeur normale quand le bouton est relâché.
Max | Min

Ecran de travail

X+ | X-
Y+

Y-

Déplacement
De l’outil

Mode filetage exterieur normal: « TH EXT N »

Motor Mode | TH EXT N
Pour faire quoi ? | Le mode « TH EXT N » permet réaliser un filetage extérieur dans le sens normal (pas à droite) en mode semi-automatique sans arrêt de la broche et avec un retour rapide en position initiale. La vitesse maximum possible du moteur entrainant le longitudinal est celle du menu « réglages » paramètre « M1 vitesse ». Il n’est pas nécessaire de prévoir une gorge sur la fin du filetage, la position d’arrêt sera toujours la même. Positionner la butée minimum en dehors de la pièce, le démarrage du filet peut être non conforme dû à l’accélération du moteur en début de cycle (voir l’Annexe 2). L’outil peut être décalé dans le pas à l’aide du paramètre « Décalage » entre 0° et 360°.

Je règle quoi avant de
démarrer ?
- Je renseigne les fins de course Min et Max. Je ne les change plus après.
- Le moteur doit être à son fin de course minimum.
- La broche doit tourner dans le sens positif ( C+) ou être arrêtée et sa vitesse doit être inférieur à la vitesse maximum de filetage calculée par le système ( voir le paramètre « Vmax »).
- Le pas désiré doit être renseigné dans le paramètre « Pas »
- Le décalage fixe en degré peut être renseigné si besoin dans le paramètre « Décalage »

Si « Fin de course » est coché, on peut alors profiter des avantages de l’utilisation de la règle sur l’axe Y du transversal comme :

- La pénétration oblique à l’angle désiré
- Les sécurités logicielles comme l’interdiction du retour rapide si l’outil n’est pas dégagé de la pièce.

Il faut bien penser si « FinDeCourse » est coché de rentrer :

- Le diamètre de la pièce en mm dans le paramètre « Diamètre »
- L’angle de plongée en degré dans le paramètre « Angle ». Un angle de 0° revient à faire une plongée droite. On choisira 30° pour un pas métrique.

Par défaut et sans la prise en compte de la position de l’axe Y du transversal, la pénétration sera droite.

Max | Min
X+ | X-
Y+

Y-

Déplacement
De l’outil

D

Zone de travail

Opération automatique

Opération manuelle

Sens de rotation
de la broche
| | D Point de départ
Comment j’active ce mode ? | Dans le menu « Menu du moteur 1 » → « Mode » = « TH EXT N »

Diameter

Ecran de travail

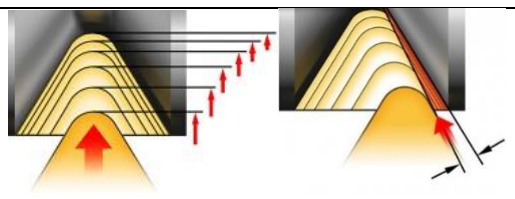
[picture p34: figure]
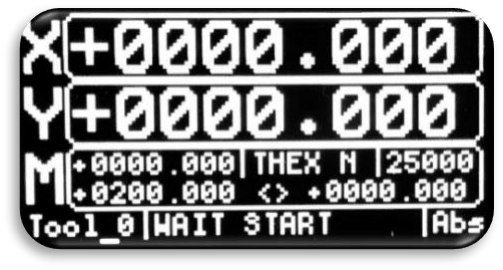
[picture p35: figure]

L’étape en cours est inscrite en bas de l’écran :

« WAIT START » : Attente du départ cycle par appui sur le bouton

« WAIT SYNC » : Le système synchronise la broche

« IN THREAD »: Filetage en cours

« WAIT RETURN » : Attente du retour par appui sur le bouton

« IN RETURN » : Retour rapide en cours

Comment j’utilise cette
fonction ?

Quand les conditions de départ sont remplies. Le filetage se fait en différente étapes :

1. L’opérateur positionne le transversal en manuel avant de lancer la première passe.
2. Lancer le cycle par un appui sur le bouton « Gauche ».

ATTENTION, la vérification de la vitesse de la broche se fait à l’appui du bouton.
Si la vitesse est trop rapide par la suite, risque de crash !

ATTENTION, Ne pas ajuster l’offset quand le broche est en rotation. Le faire avec la broche à l’arrêt.

3. Le système se synchronise avec la broche puis démarre le filetage. Le filetage se réalise alors jusqu’à la position maximum. Il n’est pas possible d’arrêter le mouvement par un appui touche jusqu’à la position maximum.
4. L’opérateur recule le transversal en manuel pour le retour rapide.
5. Lancer le retour rapide par un appui sur le bouton « Droite » Le transversal repart à sa position minimum. Attention de bien avoir dégagé l’outil. Si "FinDeCourse » est coché, La valeur de l’afficheur Y doit être supérieure à la valeur renseignée dans « Diameter » (pour éviter de casser l’outil).
6. Quand le longitudinal est arrivé à sa position minimum. L’opérateur positionne le transversal pour faire la seconde passe et il reprend à l’étape 1
7. Ainsi de suite jusqu’à la fin du filetage…

Mode filetage exterieur inversé: « TH EXT I »

Motor Mode | TH EXT N
Pour faire quoi ? | Le mode « TH EXT I » permet réaliser un filetage extérieur dans le sens inversé de la broche (pas à gauche) en mode semi-automatique sans arrêt de la broche et avec un retour rapide en position initiale. La vitesse maximum possible du moteur entrainant le longitudinal est celle du menu « réglages » paramètre « M1 vitesse ». Il n’est pas nécessaire de prévoir une gorge sur la fin du filetage, la position d’arrêt sera toujours la même. Positionner la butée minimum en dehors de la pièce, le démarrage du filet peut être non conforme dû à l’accélération du moteur en début de cycle (voir l’Annexe 2). L’outil peut être décalé dans le pas à l’aide du paramètre « Décalage » entre 0° et 360°.

Je règle quoi avant de
démarrer ?
- Je renseigne les fins de course Min et Max. Je ne les change plus après.
- Le moteur doit être à son fin de course minimum.
- La broche doit tourner dans le sens positif ( C-) ou être arrêtée et sa vitesse doit être inférieur à la vitesse maximum de filetage calculée par le système ( voir le paramètre « Vmax »).
- Le pas désiré doit être renseigné dans le paramètre « Pas »
- Le décalage fixe en degré peut être renseigné si besoin dans le paramètre « Décalage »

Si « Fin de course » est coché, on peut alors profiter des avantages de l’utilisation de la règle sur l’axe Y du transversal comme :

- La pénétration oblique à l’angle désiré
- Les sécurités logicielles comme l’interdiction du retour rapide si l’outil n’est pas dégagé de la pièce.

Il faut bien penser si « FinDeCourse » est coché de rentrer :

- Le diamètre de la pièce en mm dans le paramètre « Diamètre »
- L’angle de plongée en degré dans le paramètre « Angle ». Un angle de 0° revient à faire une plongée droite. On choisira 30° pour un pas métrique.

Par défaut et sans la prise en compte de la position de l’axe Y du transversal, la pénétration sera droite.

Max | Min
X+ | X-
Y+

Y-

Déplacement
De l’outil

D

Zone de travail

Opération automatique

Opération manuelle

Sens de rotation
de la broche
| | D Point de départ
Comment j’active ce mode ? | Dans le menu « Menu du moteur 1 » → « Mode » = « TH EXT I »

Diameter

Ecran de travail

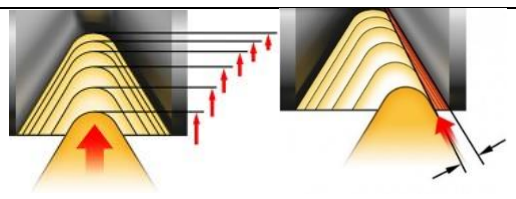
[picture p36: figure]
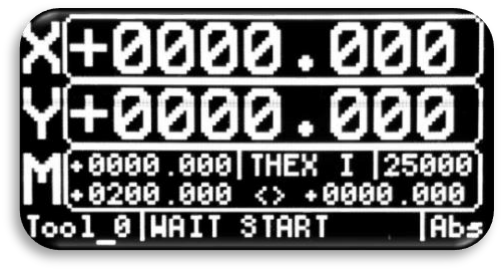
[picture p37: figure]

L’étape en cours est inscrite en bas de l’écran :

« WAIT START » : Attente du départ cycle par appui sur le bouton

« WAIT SYNC » : Le système synchronise la broche

« IN THREAD »: Filetage en cours

« WAIT RETURN » : Attente du retour par appui sur le bouton

« IN RETURN » : Retour rapide en cours

Comment j’utilise cette
fonction ?

Quand les conditions de départ sont remplies. Le filetage se fait en différente étapes :

1. L’opérateur positionne le transversal en manuel avant de lancer la première passe.
2. Lancer le cycle par un appui sur le bouton « Gauche ».

ATTENTION, la vérification de la vitesse de la broche se fait à l’appui du bouton.
Si la vitesse est trop rapide par la suite, risque de crash !

ATTENTION, Ne pas ajuster l’offset quand le broche est en rotation.
Le faire avec la broche à l’arrêt.
3. Le système se synchronise avec la broche puis démarre le filetage. Le filetage se réalise alors jusqu’à la position maximum. Il n’est pas possible d’arrêter le mouvement par un appui touche jusqu’à la position maximum.
4. L’opérateur recule le transversal en manuel pour le retour rapide.
5. Lancer le retour rapide par un appui sur le bouton « Droite » Le transversal repart à sa position minimum. Attention de bien avoir dégagé l’outil. Si « FinDeCourse » est coché, La valeur de l’afficheur Y doit être supérieure à la valeur renseignée dans « Diameter » (pour éviter de casser l’outil).
6. Quand le longitudinal est arrivé à sa position minimum. L’opérateur positionne le transversal pour faire la seconde passe et il reprend à l’étape 1
7. Ainsi de suite jusqu’à la fin du filetage…

Mode filetage interieur normal: « TH INT N »

Motor Mode | TH INT N
Pour faire quoi ? | Le mode « TH INT N » permet réaliser un filetage intérieur dans le sens normal (pas à gauche) en mode semi-automatique sans arrêt de la broche et avec un retour rapide en position initiale. La vitesse maximum possible du moteur entrainant le longitudinal est celle du menu « réglages » paramètre « M1 vitesse ». Il n’est pas nécessaire de prévoir une gorge sur la fin du filetage, la position d’arrêt sera toujours la même. Positionner la butée minimum en dehors de la pièce, le démarrage du filet peut être non conforme dû à l’accélération du moteur en début de cycle (voir l’Annexe 2). L’outil peut être décalé dans le pas à l’aide du paramètre « Décalage » entre 0° et 360°.

Je règle quoi avant de
démarrer ?
- Je renseigne les fins de course Min et Max. Je ne les change plus après.
- Le moteur doit être à son fin de course minimum.
- La broche doit tourner dans le sens positif ( C+) ou être arrêtée et sa vitesse doit être inférieur à la vitesse maximum de filetage calculée par le système ( voir le paramètre « Vmax »).
- Le pas désiré doit être renseigné dans le paramètre « Pas »
- Le décalage fixe en degré peut être renseigné si besoin dans le paramètre « Décalage »

Si « Fin de course » est coché, on peut alors profiter des avantages de l’utilisation de la règle sur l’axe Y du transversal comme :

- La pénétration oblique à l’angle désiré
- Les sécurités logicielles comme l’interdiction du retour rapide si l’outil n’est pas dégagé de la pièce.

Il faut bien penser si « FinDeCourse » est coché de rentrer :

- Le diamètre de la pièce en mm dans le paramètre « Diamètre »
- L’angle de plongée en degré dans le paramètre « Angle ». Un angle de 0° revient à faire une plongée droite. On choisira 30° pour un pas métrique.

Par défaut et sans la prise en compte de la position de l’axe Y du transversal, la pénétration sera droite.

Max | Min
X+ | X-
| | Y+
Comment j’active ce mode ? | Dans le menu « Menu du moteur 1 » → « Mode » = « TH INT N »

Y-

Déplacement
De l’outil

D

Zone de travail

Opération automatique

Opération manuelle

Sens de rotation
de la broche

D Point de départ

Diameter

Ecran de travail

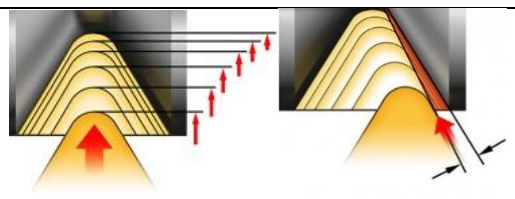
[picture p38: figure]
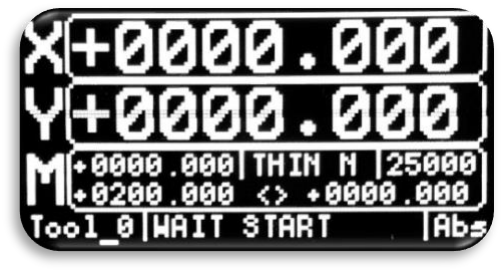
[picture p39: figure]

L’étape en cours est inscrite en bas de l’écran :

« WAIT START » : Attente du départ cycle par appui sur le bouton

« WAIT SYNC » : Le système synchronise la broche

« IN THREAD »: Filetage en cours

« WAIT RETURN » : Attente du retour par appui sur le bouton

« IN RETURN » : Retour rapide en cours

Comment j’utilise cette
fonction ?

Quand les conditions de départ sont remplies. Le filetage se fait en différente étapes :

1. L’opérateur positionne le transversal en manuel avant de lancer la première passe.
2. Lancer le cycle par un appui sur le bouton « Gauche ».

ATTENTION, la vérification de la vitesse de la broche se fait à l’appui du bouton.
Si la vitesse est trop rapide par la suite, risque de crash !

ATTENTION, Ne pas ajuster l’offset quand le broche est en rotation. Le faire avec la broche à l’arrêt.

3. Le système se synchronise avec la broche puis démarre le filetage. Le filetage se réalise alors jusqu’à la position maximum. Il n’est pas possible d’arrêter le mouvement par un appui touche jusqu’à la position maximum.
4. L’opérateur avance le transversal en manuel pour le retour rapide.
5. Lancer le retour rapide par un appui sur le bouton « Droite » Le transversal repart à sa position minimum. Attention de bien avoir dégagé l’outil. Si « FinDeCourse » est coché, La valeur de l’afficheur Y doit être inférieur à la valeur renseignée dans « Diameter » (pour éviter de casser l’outil).
6. Quand le longitudinal est arrivé à sa position minimum. L’opérateur positionne le transversal pour faire la seconde passe et il reprend à l’étape 1
7. Ainsi de suite jusqu’à la fin du filetage…

Mode filetage interieur inversé: « TH INT I »

Motor Mode | TH INT N
Pour faire quoi ? | Le mode « TH INT I » permet réaliser un filetage intérieur dans le sens inversé (pas à droite) en mode semi-automatique sans arrêt de la broche et avec un retour rapide en position initiale. La vitesse maximum possible du moteur entrainant le longitudinal est celle du menu « réglages » paramètre « M1 vitesse ». Il n’est pas nécessaire de prévoir une gorge sur la fin du filetage, la position d’arrêt sera toujours la même. Positionner la butée minimum en dehors de la pièce, le démarrage du filet peut être non conforme dû à l’accélération du moteur en début de cycle (voir l’Annexe 2). L’outil peut être décalé dans le pas à l’aide du paramètre « Décalage » entre 0° et 360°.

Je règle quoi avant de
démarrer ?
- Je renseigne les fins de course Min et Max. Je ne les change plus après.
- Le moteur doit être à son fin de course minimum.
- La broche doit tourner dans le sens négatif ( C-) ou être arrêtée et sa vitesse doit être inférieur à la vitesse maximum de filetage calculée par le système ( voir le paramètre « Vmax »).
- Le pas désiré doit être renseigné dans le paramètre « Pas »
- Le décalage fixe en degré peut être renseigné si besoin dans le paramètre « Décalage »

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

Il faut bien penser si « FinDeCourse » est coché de rentrer :

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

Max | Min
X+ | X-
| | Y+
Comment j’active ce mode ? | Dans le menu « Menu du moteur 1 » → « Mode » = « TH INT I »

Y-

Déplacement
De l’outil

D

Zone de travail

Opération automatique

Opération manuelle

Sens de rotation
de la broche

D Point de départ

Diameter

Ecran de travail

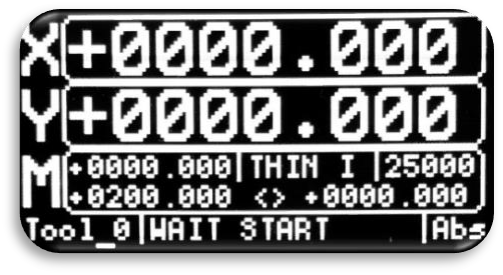
[picture p40: figure]

L’étape en cours est inscrite en bas de l’écran :

« WAIT START » : Attente du départ cycle par appui sur le bouton

« WAIT SYNC » : Le système synchronise la broche

« IN THREAD »: Filetage en cours

« WAIT RETURN » : Attente du retour par appui sur le bouton

« IN RETURN » : Retour rapide en cours

Comment j’utilise cette
fonction ?

Quand les conditions de départ sont remplies. Le filetage se fait en différente étapes :

1. L’opérateur positionne le transversal en manuel avant de lancer la première passe.
2. Lancer le cycle par un appui sur le bouton « Gauche ».

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

ATTENTION, Ne pas ajuster l’offset quand le broche est en rotation.
Le faire avec la broche à l’arrêt.
3. Le système se synchronise avec la broche puis démarre le filetage. Le filetage se réalise alors jusqu’à la position maximum. Il n’est pas possible d’arrêter le mouvement par un appui touche jusqu’à la position maximum.
4. L’opérateur avance le transversal en manuel pour le retour rapide.
5. Lancer le retour rapide par un appui sur le bouton « Droite » Le transversal repart à sa position minimum. Attention de bien avoir dégagé l’outil. Si « FinDeCourse » est coché, La valeur de l’afficheur Y doit être inférieur à la valeur renseignée dans « Diameter » (pour éviter de casser l’outil).
6. Quand le longitudinal est arrivé à sa position minimum. L’opérateur positionne le transversal pour faire la seconde passe et il reprend à l’étape 1
7. Ainsi de suite jusqu’à la fin du filetage…

Reprise d’un filetage endommagé

Il est possible de reprendre des filetages endommagés dans les 4 modes de filetage. Pour cela, régler le système comme pour faire un filetage standard et mettant le décalage à zéro pour l’instant.

A l’étape 2 du filetage, engager le filetage avec la broche à l’arrêt et faire tourner la broche lentement (avec la main ou à vitesse réduite). Le moteur du transversal va avancer en même temps.

S’arrêter et a une position quelconque. Il est alors possible de décaler le moteur dans le menu filetage :

- « Décalage » : Valeur du décalage en degré entre 0° et 360°
- 2 boutons permettent d’ajouter ou d’enlever 2 degrés.

Quand le décalage est trouvé, reprendre le cycle de filetage normalement :

- Reculer le chariot
- Mettre la broche en route (le chariot va aller sur sa butée Max)
- Appuyer pour revenir en rapide.
- Et reprendre le cycle de filetage

Mode Cône à droite: « PROFIL »

Motor Mode | PROFIL
Pour faire quoi ? | Le mode « PROFIL » permet réaliser différents profils en intérieur/extérieur et dans les deux directions. Le moteur se retrouve asservi aux déplacements du transversal (Y). Exemple ici avec un cône extérieur de droite à gauche.
Diamètre | | X+ X-Y+
Comment j’active ce mode ? | Dans le menu « Menu du moteur 1 » • « Mode » = « PROFIL» • Dans le sous menu « Para. de profil » • Profil : « CONE » • Direction : « LEFT » • Position : « EXT »
Je règle quoi avant de démarrer ? | • Les fins de course du moteur vont se régler automatiquement, ne pas y toucher. • Le moteur doit être à sa position de Pos ou le profil va partir avec le jeu de la vis « dans le bon sens ». Il faut donc être arrivé de droite à gauche. • Je renseigne le diamètre de la forme, le diamètre de retour, la longueur et l’angle. • En choisissant un angle de 0°, on peut faire une gorge • Puis je peux revenir à l’écran de travail pour démarrer le profil.

Y-

Déplacement
De l’outil

Zone de travail
Opération automatique

Opération manuelle

Sens de rotation
de la broche
D Point de départ du cycle
Longueur | Opération Semi-auto

D

Pos

Angle

Diamètre de
retour

Ecran de travail

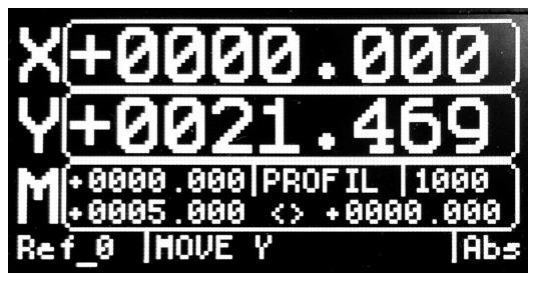
[picture p41: figure]

L’étape en cours est inscrite en bas de l’écran :

«MOVE Y » : L’axe Y doit être supérieur au diamètre de retour pour démarrer le cycle

« PRESS OK » : Si la condition Y>Diamètre retour est remplie, appuyer sur OK pour démarrer le cycle.

« Y TO PROFIL »: ramener l’axe Y jusqu’à l’apparition du message « IN PROFIL »

« IN PROFIL » : Reculer l’’axe Y, l’axe X va suivre le profil et finir en reculant l’axe Y pour qu’il soit supérieur au diamètre de retour.

« IN RETURN » : Retour rapide en cours pour repositionnement pour la passe suivante.

Comment j’utilise cette
fonction ?

Quand les conditions de départ sont remplies. Le profil se fait en différentes étapes :

1. L’opérateur positionne le transversal en manuel avant de lancer le cycle pour que l’axe Y soit supérieur au diamètre de retour.
2. Lancer le cycle par un appui sur le bouton « OK ». On commence alors la première passe.
3. Avancer le transversal jusqu’à la profondeur de la première passe. L’écran passe alors de « Y TO PROFIL » à « IN PROFIL »
4. Reculer doucement alors le transversal pour que l’outil se déplace dans le profil. La vitesse maximum du moteur peut être ajustée avec les touches « Haut » et « Bas ».
5. Quand l’outil a décrit tout le profil, reculer le transversal au-delà du diamètre de retour.
6. Le système ramène alors l’outil au point de départ en rapide en compensant le jeu de la vis.
7. Reprendre à l’étape 3 jusqu’à la dernière passe qui peut être répétée plusieurs fois.

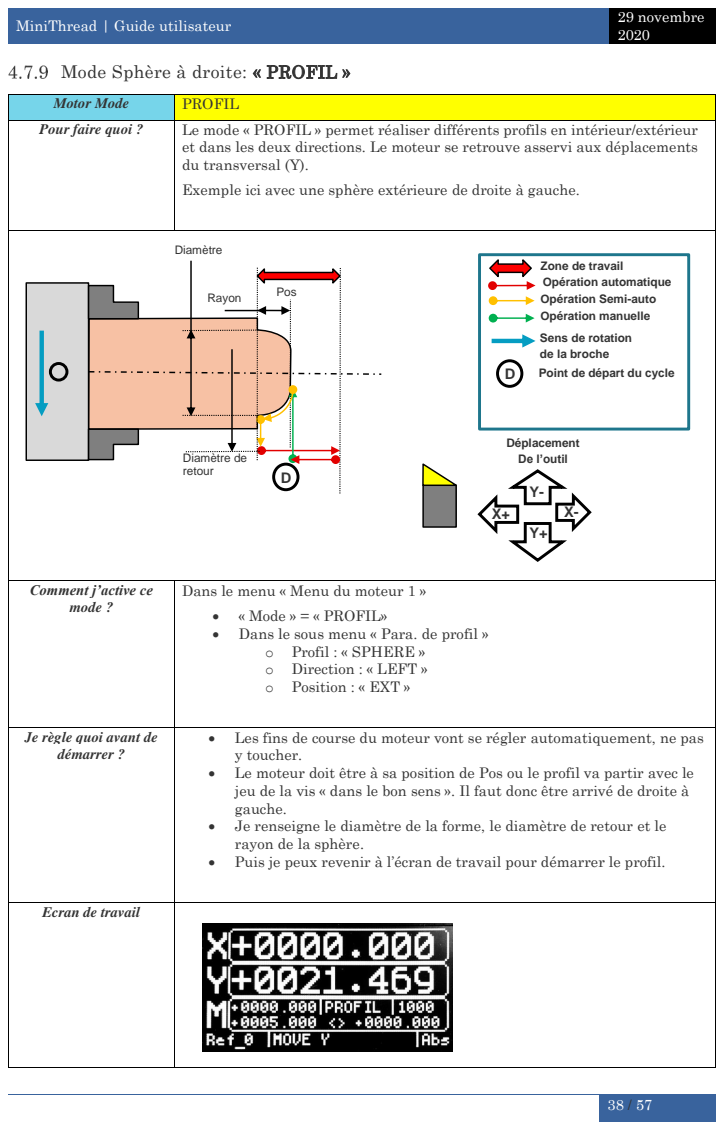
[picture p42: page 39]
Déplacement De l’outil; Opération manuelle; Rayon; Opération Semi-auto; Pos; Diamètre de retour

Mode Sphère à droite: « PROFIL »

Motor Mode | PROFIL
Pour faire quoi ? | Le mode « PROFIL » permet réaliser différents profils en intérieur/extérieur et dans les deux directions. Le moteur se retrouve asservi aux déplacements du transversal (Y). Exemple ici avec une sphère extérieure de droite à gauche.

Diamètre | | X+ X-Y+

Zone de travail
Opération automatique

Sens de rotation
de la broche

D Point de départ du cycle

Comment j’active ce mode ? | Dans le menu « Menu du moteur 1 » • « Mode » = « PROFIL» • Dans le sous menu « Para. de profil » • Profil : « SPHERE » • Direction : « LEFT » • Position : « EXT »

Je règle quoi avant de démarrer ? | • Les fins de course du moteur vont se régler automatiquement, ne pas y toucher. • Le moteur doit être à sa position de Pos ou le profil va partir avec le jeu de la vis « dans le bon sens ». Il faut donc être arrivé de droite à gauche. • Je renseigne le diamètre de la forme, le diamètre de retour et le rayon de la sphère. • Puis je peux revenir à l’écran de travail pour démarrer le profil.

Ecran de travail

L’étape en cours est inscrite en bas de l’écran :

«MOVE Y » : L’axe Y doit être supérieur au diamètre de retour pour démarrer le cycle

« PRESS OK » : Si la condition Y>Diamètre retour est remplie, appuyer sur OK pour démarrer le cycle.

« Y TO PROFIL » : ramener l’axe Y jusqu’à l’apparition du message « IN PROFIL »

« IN PROFIL » : Reculer l’’axe Y, l’axe X va suivre le profil et finir en reculant l’axe Y pour qu’il soit supérieur au diamètre de retour.

« IN RETURN » : Retour rapide en cours pour repositionnement pour la passe suivante.

Comment j’utilise cette
fonction ?

Quand les conditions de départ sont remplies. Le profil se fait en différentes étapes :

8. L’opérateur positionne le transversal en manuel avant de lancer le cycle pour que l’axe Y soit supérieur au diamètre de retour.
9. Lancer le cycle par un appui sur le bouton « OK ». On commence alors la première passe.
10. Avancer le transversal jusqu’à la profondeur de la première passe. L’écran passe alors de « Y TO PROFIL » à « IN PROFIL »
11. Reculer doucement alors le transversal pour que l’outil se déplace dans le profil. La vitesse maximum du moteur peut être ajustée avec les touches « Haut » et « Bas ».
12. Quand l’outil a décrit tout le profil, reculer le transversal au-delà du diamètre de retour.
13. Le système ramène alors l’outil au point de départ en rapide en compensant le jeu de la vis.
14. Reprendre à l’étape 3 jusqu’à la dernière passe qui peut être répétée plusieurs fois.

Messages d’alertes pendant les modes du moteur

Pendant les différents Mode de fonctionnement du moteur, le système va alerter l’utilisateur en cas de problème détecté et bloquera jusqu’à la correction du problème.

(Message en langue française ou anglaise selon le choix de la langue)

Messages d’alerte | Explications

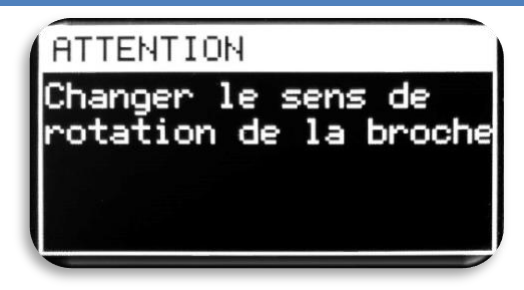
[picture p43: figure]

| La broche tourne dans le mauvais sens (le départ du cycle est impossible). Correction : Inverser le sens de rotation de la broche.

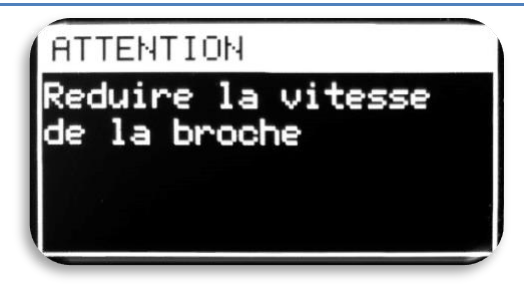
[picture p44: figure]

| La broche tourne trop vite. Correction : Réduire la vitesse de rotation de la broche (la vitesse maximum admissible est consultable par le paramètre « Speed max »)

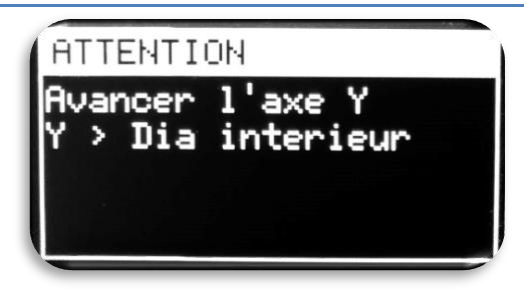
[picture p45: figure]

| La position de l’outil est supérieure au diamètre sélectionné. Ramener la position (si « Fin de course » est coché). Correction : Déplacer le longitudinal en avançant le longitudinal

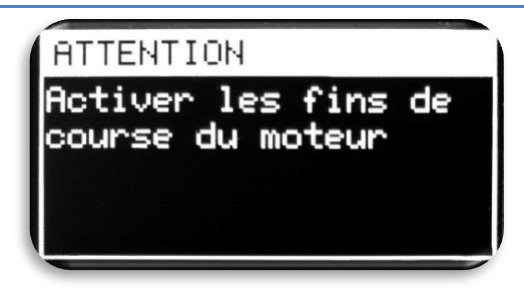
[picture p46: figure]

| Les fins de course ne sont pas activés (Il n’est pas possible de faire un cycle sans fin de course). Correction : Activer les fins de course dans le menu.

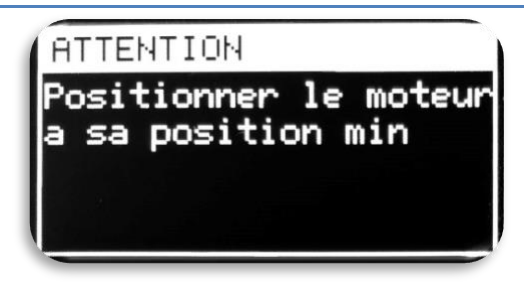
[picture p47: figure]

| Le moteur n’est pas à son fin de course minimum. Correction : Repasser en manuel pour ramener le moteur à sa position minimum et relancer le cycle.

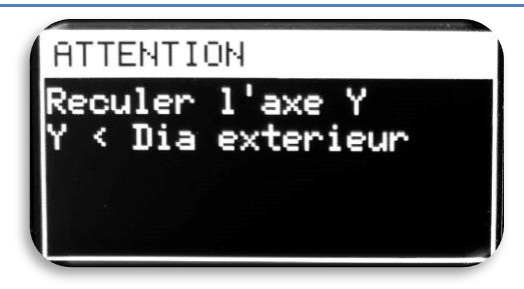
[picture p48: figure]

La position de l’outil est inférieure au diamètre sélectionné (si « Fin de course » est coché).

Correction :

Déplacer le longitudinal en le reculant

### 5. ANNEXE

## 5.1 Annexe 1 : Le moteur pas à pas

Source : https://www.omega.fr/prodinfo/Moteur-pas-a-pas.html

Le moteur pas à pas

Un moteur pas à pas est un moteur électrique synchrone sans frotteurs qui convertit les impulsions numériques en rotation de l'arbre mécanique.

Chaque révolution du moteur pas à pas est divisée en un nombre de pas distincts, 200 pas dans la majorité des cas, et le moteur doit recevoir une impulsion distincte pour chaque pas. Le moteur pas à pas ne peut avoir qu'un seul pas à la fois, et chaque pas est de la même taille. Puisque chaque impulsion fait tourner le moteur à un angle précis, généralement de 1,8 °, la position du moteur peut être contrôlée sans aucun mécanisme de rétroaction. Lorsque les impulsions numériques augmentent en fréquence, le mouvement de pas se transforme en rotation continue, avec une vitesse de rotation directement proportionnelle à la fréquence des impulsions. Les moteurs pas à pas sont utilisés quotidiennement dans les applications industrielles et commerciales en raison de leur faible coût, de leur haute fiabilité, de leur couple élevé à basse vitesse et de leur construction simple et robuste qui fonctionne dans presque n'importe quel environnement.

Avantages du moteur pas à pas :

1. L'angle de rotation du moteur pas à pas est proportionnel à l'impulsion d'entrée.
2. Le moteur pas à pas a un couple complet à l'arrêt (si les enroulements sont sous tension).
3. Un positionnement précis et la répétabilité du mouvement puisque les bons moteurs pas à pas ont une précision de 3 à 5 % pour un pas et que cette erreur est non cumulative d’un pas à l’autre.
4. Excellente réponse pour le démarrage/arrêt/fonctionnement inverse.
5. Très fiable puisqu’il n’y a aucun balai dans le moteur. La durée de vie du moteur pas à pas dépend donc simplement de la durée de vie du roulement.
6. La réponse des moteurs pas à pas à des impulsions d'entrée numériques fournit un contrôle à boucle ouverte, rendant le contrôle du moteur pas à pas plus simple et moins coûteux.
7. Il est possible de réaliser une rotation synchrone à vitesse très réduite avec une charge qui est directement couplée à l’arbre.
8. Une large gamme de vitesses de rotation peut être réalisée puisque la vitesse est proportionnelle à la fréquence des impulsions d’entrée.

Modes de pas

Les « modes de pas » des moteurs pas à pas comprennent le mode complet, le mode demi-pas et le mode micropas.

PAS COMPLET

Les moteurs pas à pas hybride standard ont 200 dents de rotor, ou 200 pas complets pour un tour de l'arbre du moteur. En divisant les 200 pas par les 360° de rotation on obtient un angle de pas complet de 1,8 °. Normalement, le mode complet est obtenu en mettant sous tension les deux enroulements tout en inversant le courant alternativement. Fondamentalement, une impulsion numérique à partir de l'entraînement équivaut à un pas.

DEMI-PAS

Demi-pas signifie simplement que le moteur pas à pas tourne à 400 pas par tour. Dans ce mode, un enroulement est mis sous tension et ensuite deux enroulements sont alimentés alternativement, ce qui fait que le rotor ne tourne que sur la moitié de la distance, soit 0,9 °. Même s'il fournit environ 30 %

moins de couple, le mode demi-pas produit un mouvement avec moins d'à-coups que le mode pas complet.

MICROPAS

Le micropas est une technologie relativement nouvelle pour les moteurs pas à pas, qui contrôle le courant dans l'enroulement à un degré qui subdivise davantage le nombre de positions entre les pôles du moteur. Le micropas est généralement utilisé dans les applications nécessitant un positionnement précis et un mouvement sans à-coups sur une large plage de vitesses. Comme le mode demi-pas, le micropas fournit environ 30 % moins de couple que le mode pas complet.

Contrôle de mouvement linéaire

Le mouvement de rotation d'un moteur pas à pas peut être converti en mouvement linéaire en utilisant un système d'entraînement par roues à vis sans fin/mère. Le rendement de la vis mère est la distance linéaire parcourue pour un tour de la vis. Si le rendement est égal à 25,4 mm (1 po) par révolution, et qu'il y a 200 pas complets par tour, alors la résolution du système de vis mère est de 0,013 cm (0,005 po)/pas. Une résolution encore plus fine est possible en utilisant le système de moteur/d'entraînement pas à pas en mode micropas.

Connexion en série ou connexion en parallèle

Il y a deux manières de raccorder un moteur pas à pas : en série ou en parallèle. Une connexion en série fournit une inductance élevée et donc un plus grand couple à basse vitesse. Une connexion en parallèle réduira l'inductance, ce qui se traduira par une augmentation du couple et une vitesse plus rapide.

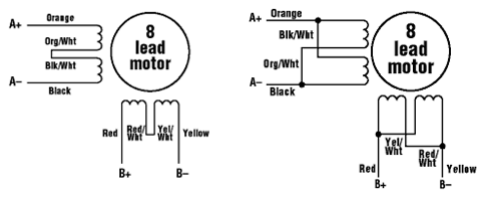
[picture p49: figure]

## 5.2 Annexe 2 : Vitesse et accélération des moteurs pas à pas

Le système MiniThread utilise une vitesse moteur en step/s et une accélération en step/s². Suivant le réglage micropas du driver, la vitesse de rotation du moteur sera différente. Je suis pour l’instant resté sur ces unités pour le moteur.

Exemple :

- Driver moteur réglé à 1600 step/tour : M1_step/tr = 1600
- Vitesse maximum à 12000 step/s : M1_speed = 12000

Vmoteur (

tour
min ) =

M1speed

M1step/tr

× 60

Ce qui donne une vitesse maximum du moteur de 450 tour/min.

L’accélération et la décélération sont exprimées en step/s² comme pour la variable système M1_accel du menu « Settings ». Cela peut être exprimé quand 1s, le système pourrait atteindre la vitesse M1_accel.

Exemple :
- Vitesse maximum à 12000 step/s : M1_speed = 12000
- Accélération à 60000 step/s² : M1_accel = 60000
- Le TimeToSpeed est le temps que va mettre le système pour atteindre sa vitesse.

TimeToSpeed(s) =

M1speed

M1accel

Le système va donc mettre 0,2s pour atteindre sa vitesse maximum.

! Si l’accélération est trop basse, le moteur ne va pas monter assez vite en vitesse pendant le filetage, il va être en retard par rapport à la broche.

! Si l’accélération est trop haute, le moteur risque de décrocher pendant la montée en vitesse avec une perte de pas.

Temps

Vitesse

Vmax

TimeToSpeed

## 5.3 Annexe 3 : Explication du fonctionnement du filetage

Pendant le filetage, l’outil va avoir une trajectoire hélicoïdale dans l’espace. En fonction de la position de la broche, l’outil (qui est mis en mouvement par le moteur pas à pas) devra se trouver à une certaine position. Par exemple après un tour de broche (360°), l’outil devra se trouver à 1 pas et ainsi de suite jusqu’à la position maximum du filetage. Le moteur pendant toute cette séquence va faire du suivi de position que l’on calculera en fonction de la position de la broche.

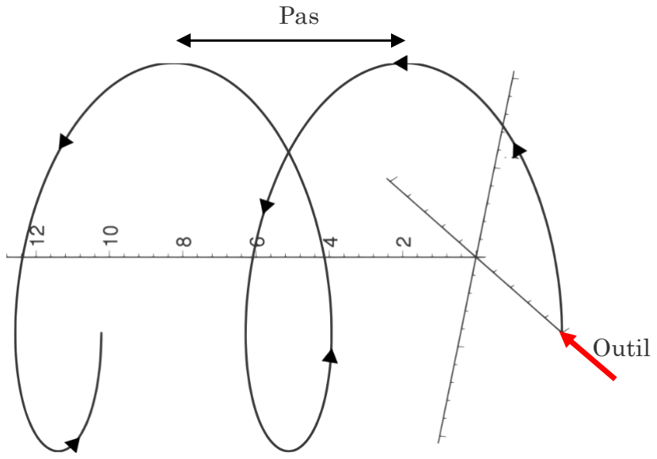
[picture p50: figure]
Outil; Pas

Le paramètre « Offset » permet de se déplacer dans le pas mais le système à aussi besoin de se déplacer dans le pas pendant les phases de plongée oblique en fonction de la position du chariot longitudinal par rapport au diamètre extérieur de la pièce.

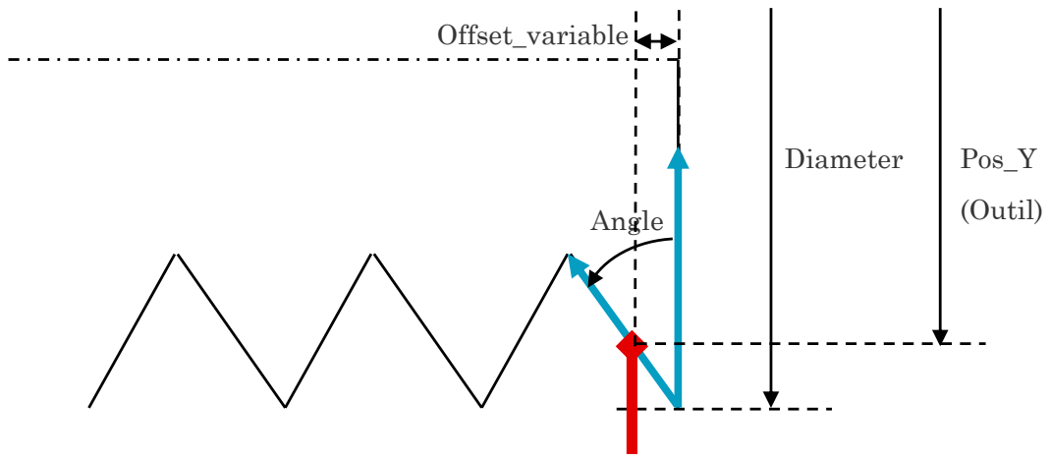
[picture p51: figure]
Diameter; Pos_Y; (Outil) Angle; Offset_variable

Calcul de l’Offset variable en fonction de la position de l’outil :

Pos_Y : Position de l’outil en mm (sur le diamètre)

Diameter : Diamètre extérieur du filetage en mm

Angle : Angle de plongé en degré (entre 0° et 45°)

Offset_variable : Décalage en step moteur

RESO_M : Résolution du moteur en step/tour (ex :1600)

PAS_M : Pas de la vis entrainée par le moteur au 1/100 de mm (ex :200)

Offset_variable =

(Diameter − PosY

)
2

× tan(Angle ×

pi
180) ×

RESOM × 100
PASM

L’offset_variable sera mis à zéro quand Pos_Y >= Diameter

Si PosY ≥ Diameter Alors Offsetvariable = 0

L’offset variable ne peut pas dépasser le demi pas demandé. Il sera borné au demi pas si dépassement.

Si Offsetvariable >

RESOM × PAS
PASM × 2

Alors Offsetvariable =

RESOM × PAS
PASM × 2

La formule de calcul complète en prenant en compte les différents paramètres du système :

RESO_M : Résolution du moteur en step/tour (ex :1600)

PAS_M : Pas de la vis entrainée par le moteur au 1/100 de mm (ex :200)

PAS : Pas demandé au 1/100 de mm (ex :125)

RESO_C : Résolution du capteur de broche (ex :1200)

POS_C : Position de la broche en step

POS_M : Position du moteur en step

OFFSET_FIXE : Offset dans le pas (permet de bouger dans le pas) entre 0°et 360°

OFFSET_VARIAVLE : Dépend de la position de l’outil sur Y

MIN_POS : Position du fin de course minimum en step

POS_M = POSC × (

RESOM × PAS
RESOC × PASM

) + MINPOS −

(360 − OFFSETFIXE) × PAS × RESOM 360 × PASM

+ OFFSET_variable

Ce calcul est réalisé avant chaque step moteur, on peut donc faire ce calcul jusqu’à 30000 fois/s en fonction de la vitesse de rotation du moteur pas à pas.

Pour accélérer ce calcul, on le réduit à 3 opérations avec un numérateur, un dénominateur et un offset qui sont calculés avant chaque passe de filetage.

POS_M = POS_C × (

NUMERATEUR
DENOMINATEUR) +OFFSET
- Comment le système fait pour rester dans le pas quand on fait la seconde passe ?

Le capteur de rotation de la broche à un certain nombre d’impulsions par tour, par exemple 1200. La carte voit donc quand le broche tourne, son compteur interne augmentée de 1200 pas par tour de broche. A 500 tours/min, le compteur augmente donc de 600000 pas par minute ! Difficile donc de calculer ou est le zéro.

Pour toujours connaître la position de la broche sur un tour, on va exploiter une des fonctionnalités du microcontrôleur avec son décodeur de signaux en quadrature. On peut régler une valeur à laquelle le compteur va se remettre à zéro. On va donc régler cette valeur au nombre de pas que fait la broche sur un tour. Ce compteur va donc se remettre à zéro à chaque passage par zéro de la broche. On peut donc en permanence connaitre la position angulaire de la broche et savoir quand la broche est à zéro (ce passage par zéro est le top de départ du filetage).

- Qu’elle est l’influence de l’accélération pendant le filetage ?

Comme dit précédemment, le moteur va attendre le passage par zéro de la broche pour démarrer son suivi de position. Il est alors arrêté. Il va donc partir d’une vitesse nul et accélérer pour rejoindre cette position. Donc, suivant l’accélération choisie, le début du filetage ne vas pas être « conforme ». Il est donc important de choisir la valeur d’accélération/décélération la plus haute et de démarrer le filetage légèrement en dehors de la pièce.

- Qu’elle est l’influence de la décélération en fin de filetage ?

Comme précédemment, le moteur va ralentir en fin de filetage pour arriver sur sa butée à vitesse nul. La fin du filetage ne va donc pas être « conforme ». Il est donc important de choisir la valeur d’accélération/décélération la plus haute.

## 5.4 Annexe 4 : La partie hardware de la carte

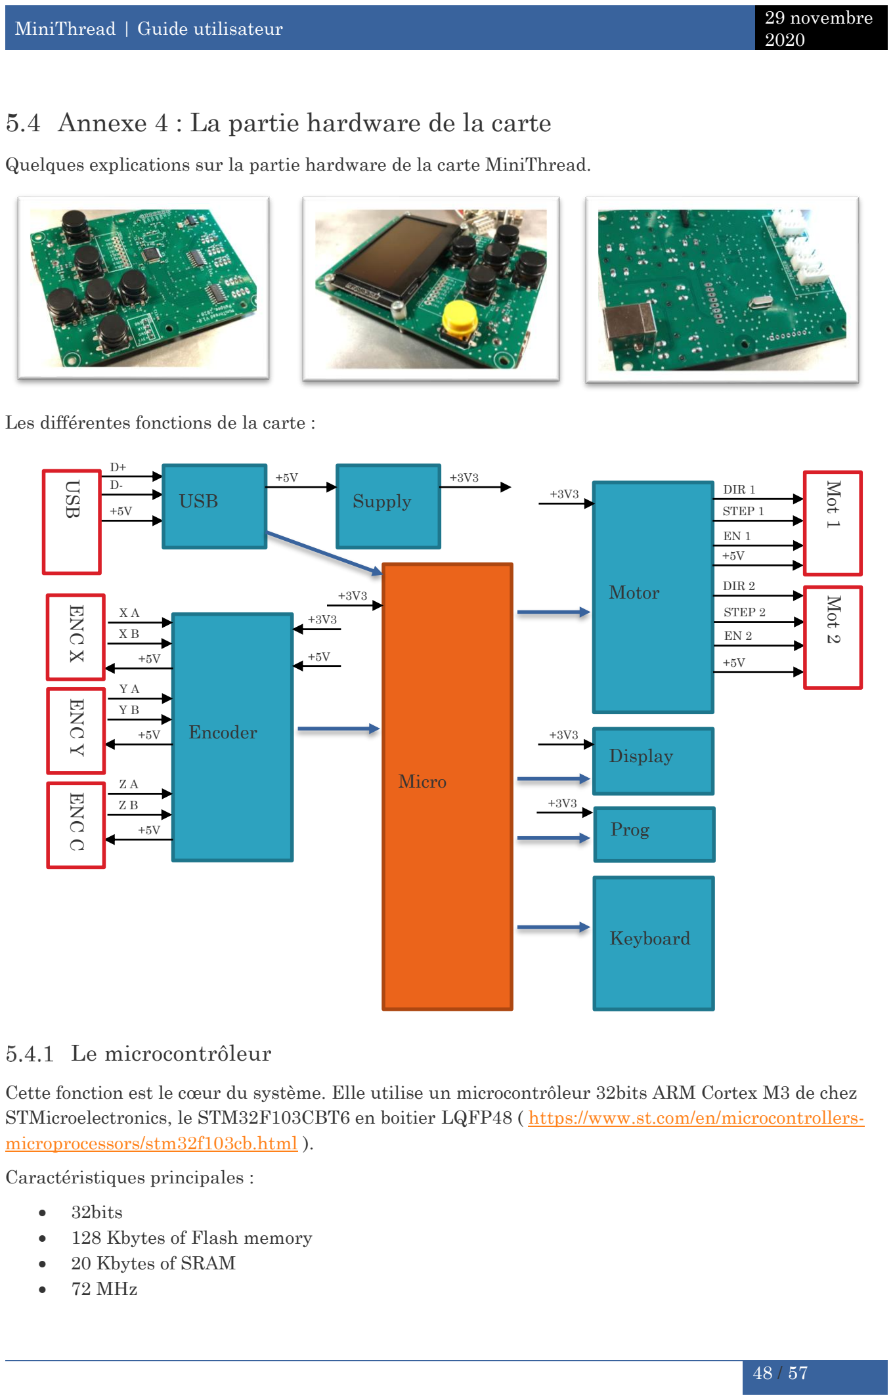
[picture p52: page 49]

Quelques explications sur la partie hardware de la carte MiniThread.

Les différentes fonctions de la carte :

Le microcontrôleur

Cette fonction est le cœur du système. Elle utilise un microcontrôleur 32bits ARM Cortex M3 de chez STMicroelectronics, le STM32F103CBT6 en boitier LQFP48 ( https://www.st.com/en/microcontrollers-microprocessors/stm32f103cb.html (https://www.st.com/en/microcontrollers-microprocessors/stm32f103cb.html) ).

Caractéristiques principales :

- 32bits
- 128 Kbytes of Flash memory
- 20 Kbytes of SRAM
- 72 MHz

+5V

D+
D-

Micro

Encoder

Motor

Display

USB | Supply

DIR 1

STEP 1

EN 1

DIR 2

STEP 2

EN 2

+5V

+5V

Mot 1 Mot 2

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
ENC X ENC Y ENC C

+5V | +3V3

+3V3

+3V3

+3V3

+5V

+3V3

USB

Prog

+3V3

Keyboard

La carte est cadencée par un quartz externe à 8Mhz avec l’utilisation d’une PLL interne pour monter à 72 MHz.

Un circuit RC externe sert pour le reset du microcontrôleur.

Supply

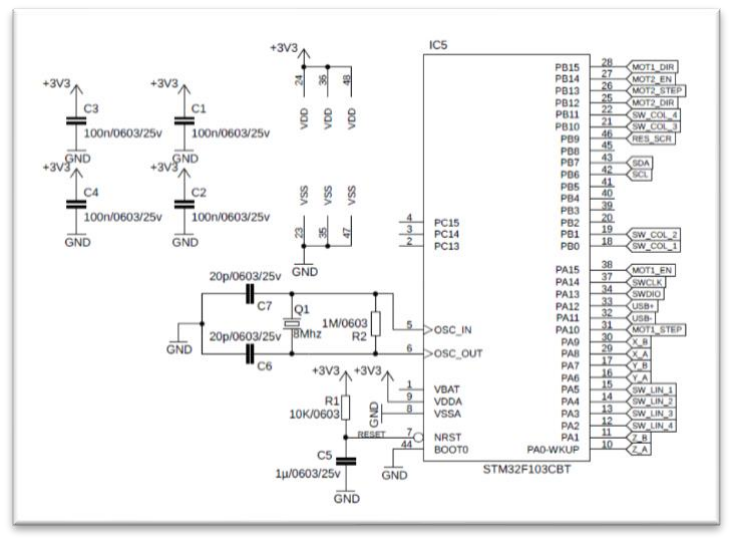
[picture p53: figure]

Cette fonction convertit le 5v venant du port USB en 3V3 par l’intermédiaire d’un régulateur LDO ( TI / LM1117MMP-3-3). Le 5v est repris directement sur le port USB.

Motor

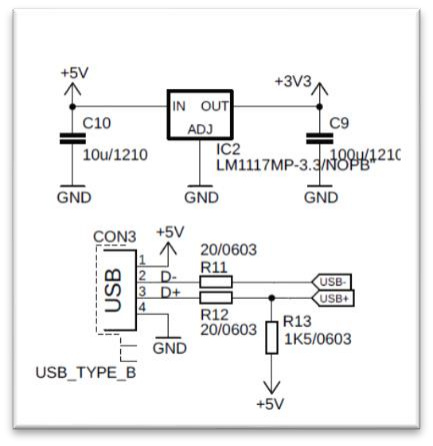
[picture p54: figure]

Cette fonction permet de commander les signaux EN, STEP et DIR des contrôleurs pour moteur pas à pas externe. Les sorties sont du type collecteur ouvert grâce à l’utilisation d’un circuit intégré ULN2003LVDR. Le courant maximum par sortie est de 140mA.

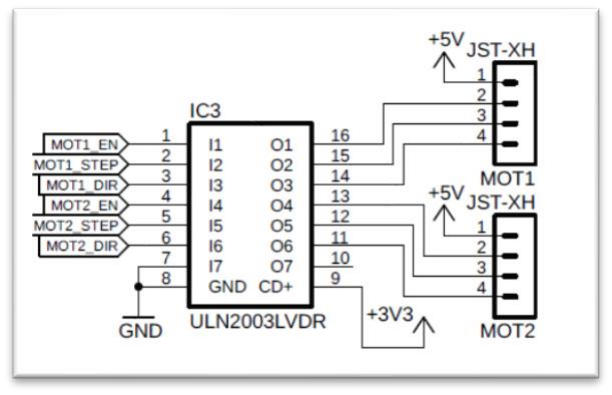
[picture p55: figure]

Une sortie collecteur ouvert :

Source : https://fr.wikipedia.org/wiki/Sortie_collecteur_ouvert

Encoder

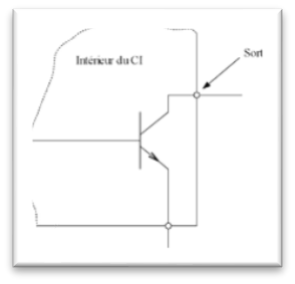
[picture p56: figure]

Cette fonction adapte les niveaux des signaux des encodeurs externe (A et B) avant d’arriver dans le microcontrôleur.

La carte est munie de connecteurs JST-XH 4 points avec un pas de 2,54mm largement répandu sur internet pour la connexion de faisceaux externe allant aux prise subd 9 broches.

Keyboard

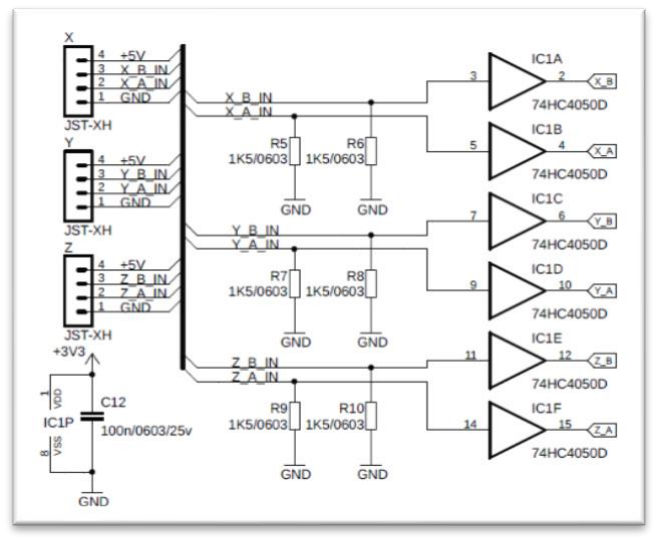
[picture p57: figure]

Le système utilise un clavier matricé de 4x4 touches. Seulement 6 touches sont montées sur la carte mais le connecteur CON1 présent sur la carte offre la possibilité de rajouter 10 touches externe (non pris en charge pour l’instant).

Les switchs utilisés sur la carte sont du type 12mmx12mm traversant (Omron / B3F-4050) mais il existe de nombreux clones sur Aliexpress.

Lien vers un vendeur sur Aliexpress de clones OMRON compatible avec les switchs OMRON : https://fr.aliexpress.com/item/32859843511.html et les capuchons adaptés : https://fr.aliexpress.com/item/32705188473.html

Display

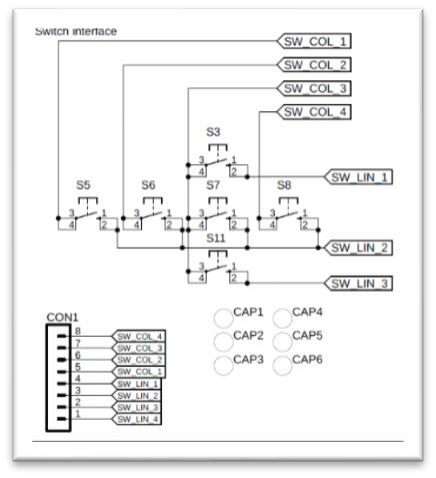
[picture p58: figure]

Utilisation d’un écran Oled de 2,42 pouces piloté en I2C avec un reset externe.

Lien vers un vendeur sur Aliexpress : https://fr.aliexpress.com/item/33024448944.html

L’écran est disponible en blanc, vert, bleu.

L’écran est alimenté en 3v3.

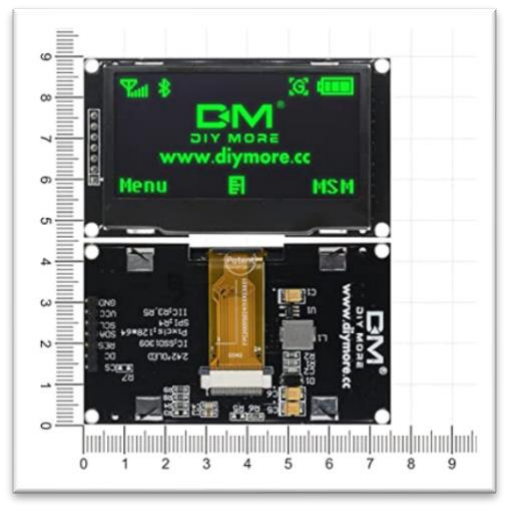
[picture p59: figure]
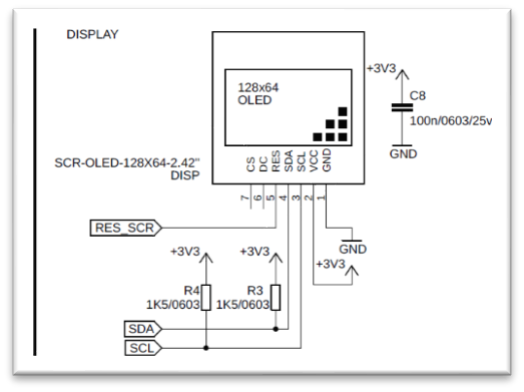
[picture p60: figure]

Prog

On retrouve dans cette fonction l’interface de programmation avec les signaux SWDIO et SWCLK. Cette fonction permet de connecter la carte à un programmateur comme le STLINK.

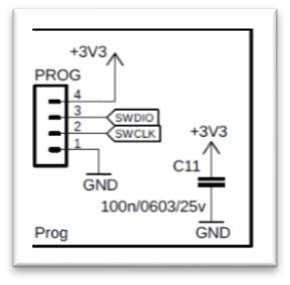
[picture p61: figure]

## 5.5 Annexe 5 : Mise à jour logiciel du boitier

La mise à jour logiciel de la carte s’effectue par le connecteur « PROG ». Pour permettre son accessibilité quand la carte est montée dans le boitier aluminium, une prise 3 points a été soudé sur la face inferieure (il ne faut pas se servir du point 3v3 ).

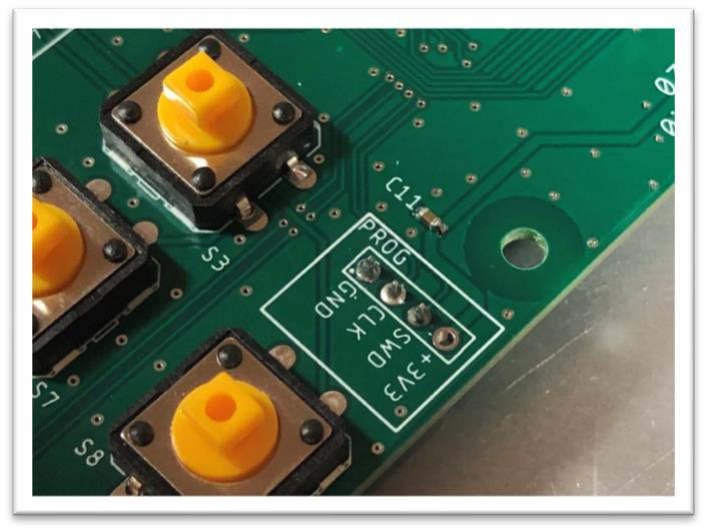
[picture p62: figure]

Le point +3V3 du connecteur ne doit pas être utilisé, la carte étant alimentée par le port usb !

La programmation s’effectue avec un programmateur Stlink v2, il existe bon nombre de clone disponible sur Aliexpress et autres sites de vente à moins de 2€.

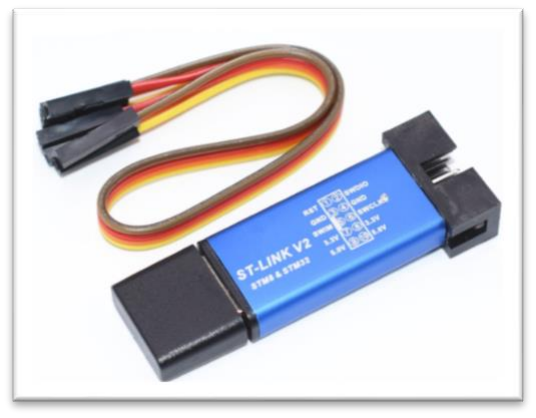
[picture p63: figure]

Branchement

Connecter le programmateur avec la carte en utilisant les liaisons fournit avec le programmateur

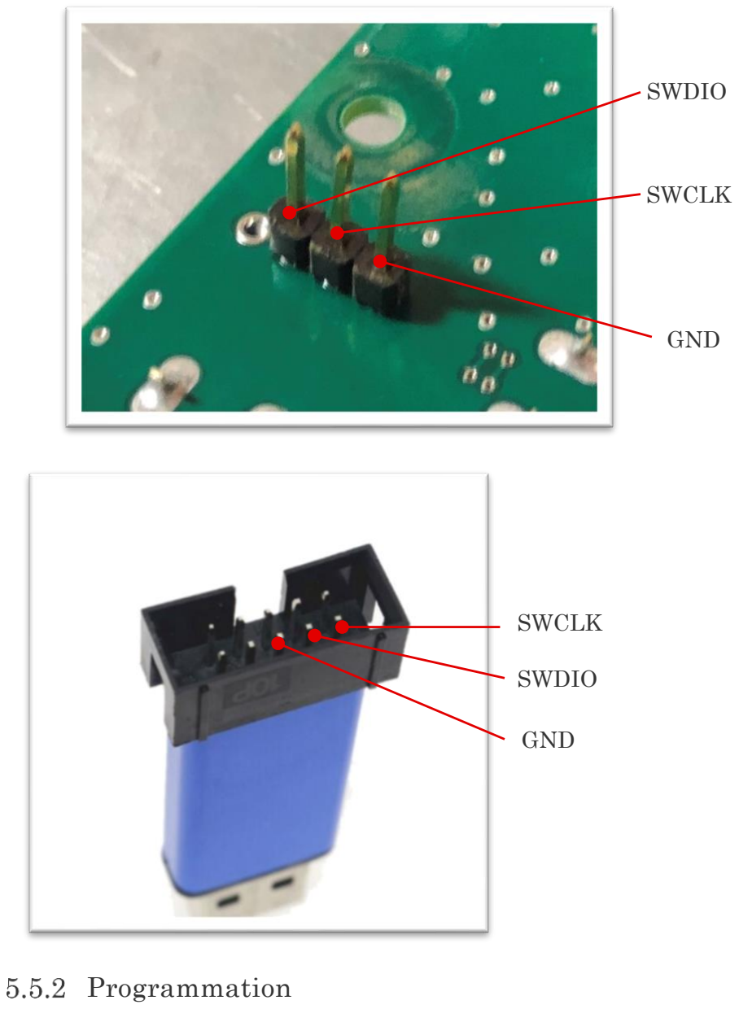
[picture p64: figure]
Programmation; GND; SWCLK; SWDIO

Etape 1. | Mettre la carte sous tension en branchant le connecteur usb sur une alimentation
Etape 2. | Connecter la carte avec le programmateur
Etape 3. | Installer le logiciel : STM32CubeProgrammer ( https://www.st.com/en/development- tools/stm32cubeprog.html (https://www.st.com/en/development-tools/stm32cubeprog.html) )
Etape 4. | Lancer le logiciel et choisir « ST-LINK » puis « Connect »

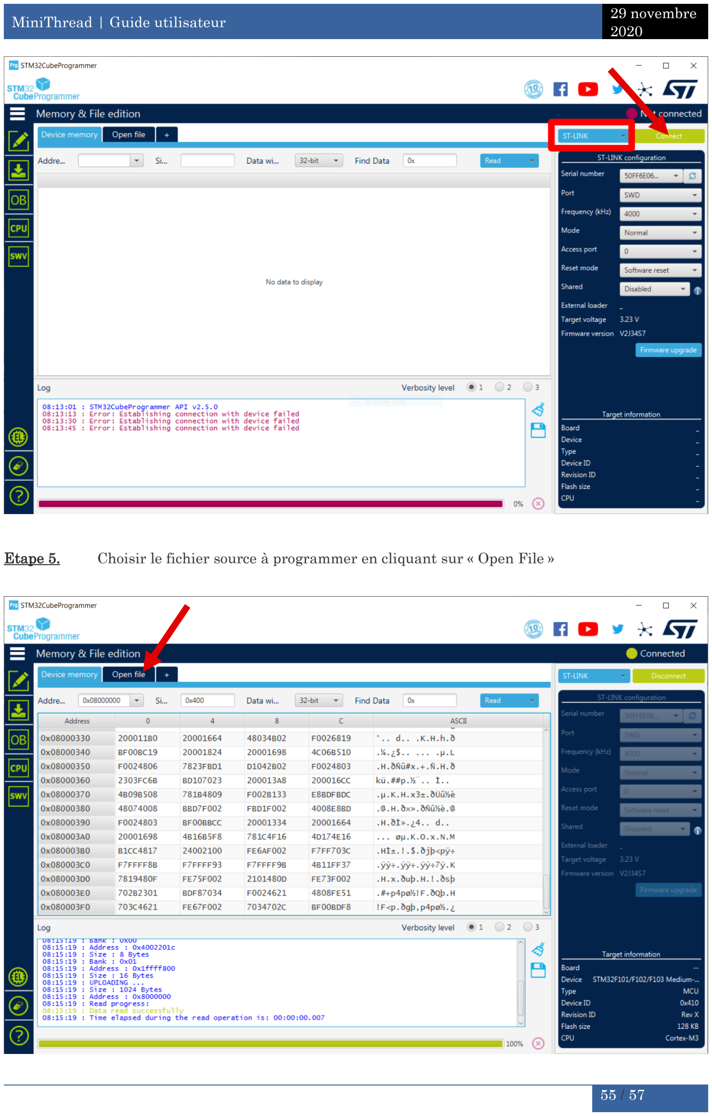
[picture p65: page 56]

Etape 5. Choisir le fichier source à programmer en cliquant sur « Open File »

Etape 6. | Le fichier chargé, cliqué sur « Download » pour programmer la carte

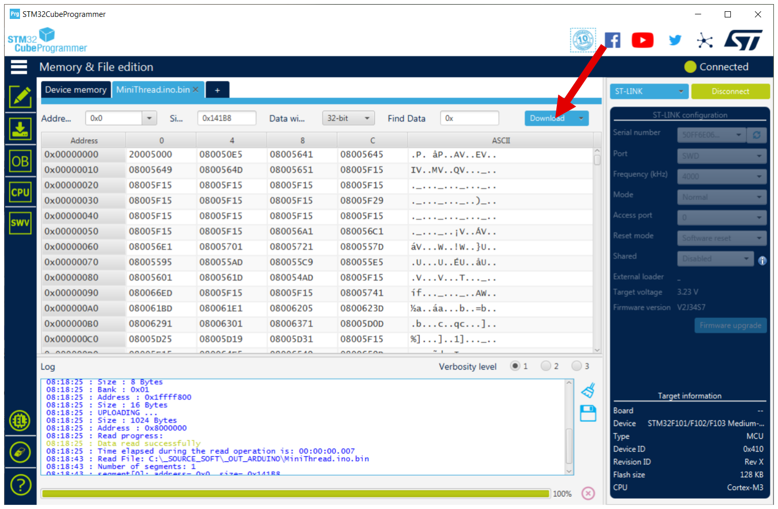
[picture p66: figure]

Etape 7. | Finir en cliquant sur « Disconnect », débrancher le programmateur de la carte, enlever puis remettre l’alimentation USB pour que la carte redémarre avec le logiciel mis à jour.
