pailpoe/MiniThread/(threads)

Thread 7 (2020-11-09):

Passage de rapide à lent

pailpoe, 2020-11-09:
En mode rapide, si on relâche les 2 boutons en même temps, la décélération est lente

pailpoe, 2020-11-12:
Disparu en corrigeant le bug de non deceleration de rapide à lent

Closed 2020-11-12.

Thread 13 (2020-11-17):

Boot difficile de l’écran.

pailpoe, 2020-11-17:
L’écran ne démarre pas tout le temps, on ne voit pas les écrans de démarrage et il reste noir.Il faut appuyer sur la touche annuler pour voir le menuarriver, après, tout est ok.

pailpoe, 2020-11-20:
Résolu avec gestion externe du reste de l’écran qui n’est plus pilote par l’instance

Closed 2020-11-20.

Thread 16 (2020-11-19):

Si pas de règle en X, possibilité d'afficher M sur la zone X

pailpoe, 2020-11-19:
Si le boitier est utilisé sans règle en X, mettre une option dans le menu settings "Change X to M = oui" permettant l'affichage de la position de M à la place de X.

Thread 18 (2020-11-22):

Améliorer l'ergonomie de réglage des butées du moteur 1

pailpoe, 2020-11-22:
Pour éviter d'avoir à les désactiver pour les réglages en manuel par exemple.
A réfléchir mais un appui sur gauche par exemple et après un appui maintenu sur "Annuler" pour passer la butée.

Closed 2020-11-26.
