pailpoe/MiniThread/src/GEM/config.h

//#include "config/enable-glcd.h"         // Enable AltSerialGraphicLCD version of GEM
#include "config/enable-u8g2.h"         // Enable U8g2 version of GEM
#include "config/support-float-edit.h"  // Support for editable float and double variables (option selects support them regardless of this setting)
