pailpoe/MiniThread/(commit log)

2020-10-01 Add float type item to GEM
    [Menu.xlsx]
2020-10-04 add button to reset current pos
    [MiniThread.ino]
2020-10-12 Ajout changement écran avec OK
    [Menu.xlsx]
2020-10-12 Up et down pour la vitesse moteur
2020-10-20 Refonte code stepper
2020-10-21 Mise en place de l'accelération sur le moteur
    Travail en cour mais le code est fonctionnel
2020-11-06 Correctif bug demarrage ecran dans cerains cas
    [MiniThread.ino]
2020-11-07 Ajout speed dans menu setting pour filetage et ecran de démarrage
2020-11-12 Correction bug passage vitesse rapide à normale sans accélération
    [MiniThread.ino, StepperMotor.cpp]
2020-11-12 Correction bug compteur C
    [MiniThread.ino, QuadDecoder.cpp]
2020-11-15 Add sub menu thread parameters
2020-11-15 Calcul des paramètres de filetage avant chaque passe
2020-11-15 ajout draft doc
    [Menu.xlsx]
2020-11-15 on enleve l'écran de debug
2020-11-19 Correction bug démarrage difficile de l'écran à certain moments
    [MiniThread.ino]
2020-11-20 Solve screen boot problem
    [MiniThread.ino]
2020-11-26 Bridage de la plongée oblique au demi pas
2020-11-26 Ajout menu shortcut et ajjustement des fins de course en manuel avec haut et bas
    [Language.h, MiniThread.ino]
2020-11-28 Refonte de la gestion des langues
2020-11-29 correction bug vitesse basse
    [Language.h, MiniThread.ino]
2020-11-29 mise a jour avant 1.1.0
    [Menu.xlsx]
2020-11-29 Revert "update ver"
    This reverts commit db4d3db142de7eb01fe0b5211cf34f7e1e36020e.
    [MiniThread.ino]
2020-11-29 Revert "Merge branch 'Dev' into main"
    This reverts commit face340028bf587dd1f20c0babd794af5204c7fe, reversing
    changes made to 262cfe5861a2384d8b0220dcb62226e8bf0868e6.
    [MiniThread.ino]
2020-11-29 Revert "mise a jour avant 1.1.0"
    This reverts commit 867302f734f14553f7b824b06180df76f1bb75d8.
    [Menu.xlsx]
2020-12-06 add doc
    [Menu.xlsx]
2020-12-11 fin de cycle profil
